FaiyuetCik/Display-Gadgets/code/images/096_nRF52840Plus_display_dashboard_motion.gif

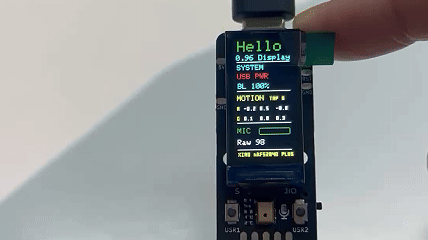
code/images/096_nRF52840Plus_display_dashboard_motion.gif
