FaiyuetCik/Display-Gadgets/code/example/096_nRF52840/crop1.jpg

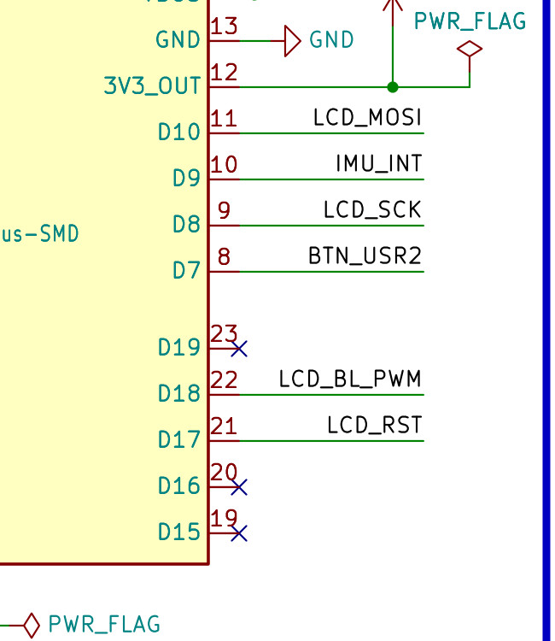
code/example/096_nRF52840/crop1.jpg
