FaiyuetCik/Display-Gadgets/code/example/096_nRF52840/crop2.jpg

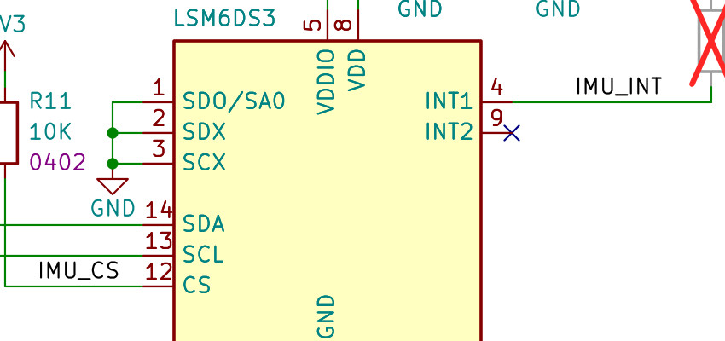
code/example/096_nRF52840/crop2.jpg
