FaiyuetCik/Display-Gadgets/code/example/096_nRF52840/schematic_main.png

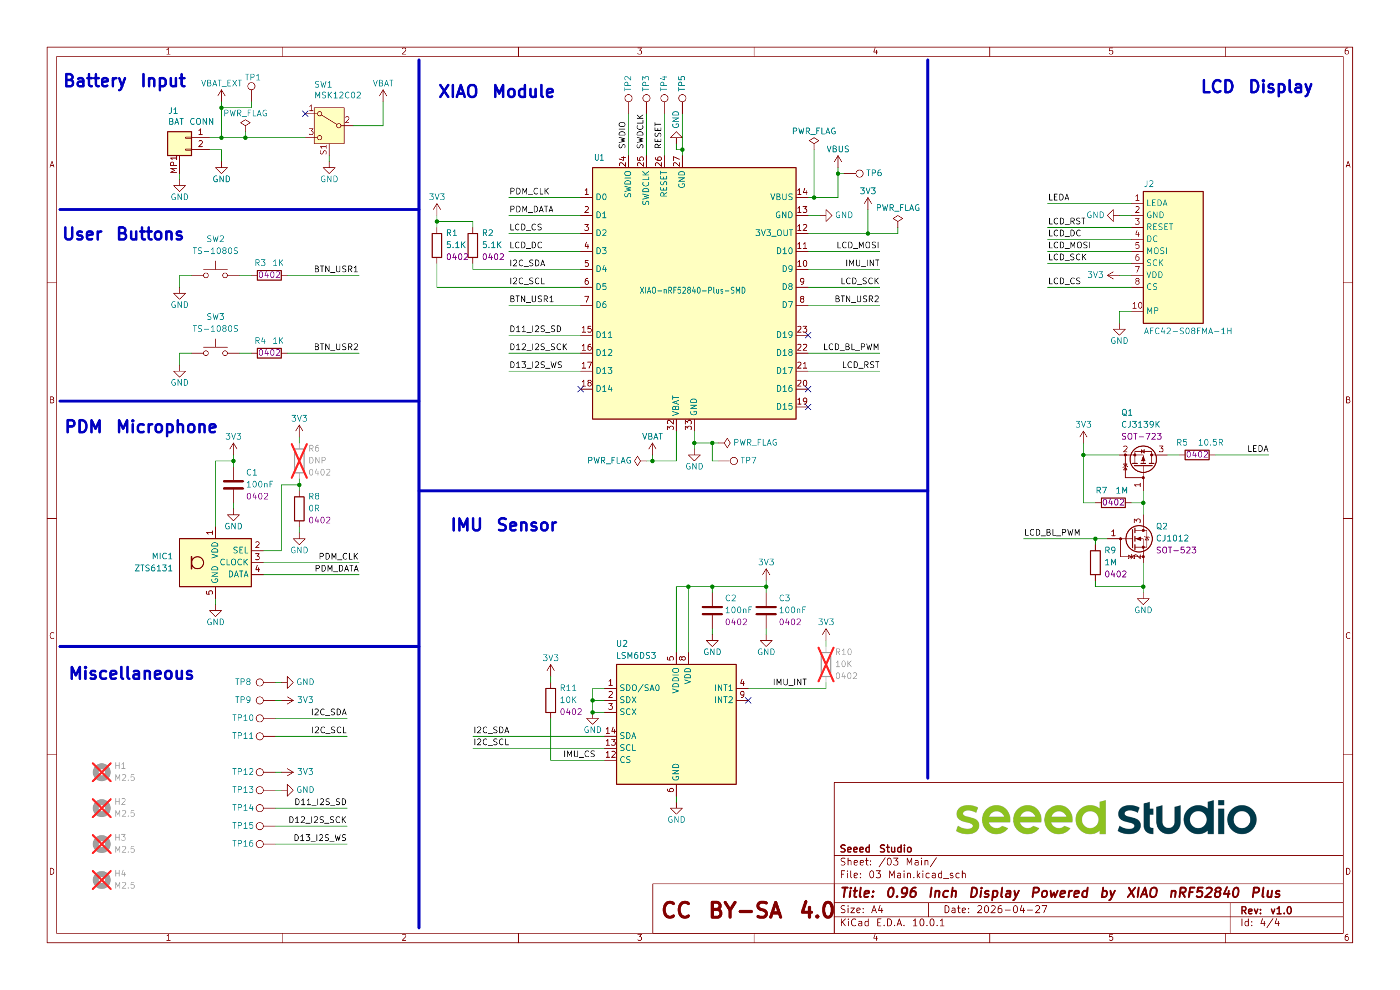
code/example/096_nRF52840/schematic_main.png
