FaiyuetCik/Display-Gadgets/code/images/096_ESP32S3Plus_display_dashboard_double_tap.gif

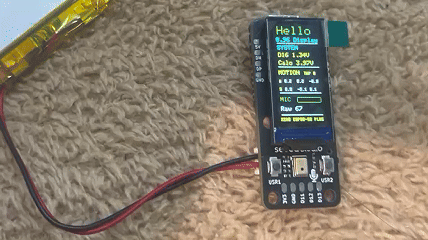
code/images/096_ESP32S3Plus_display_dashboard_double_tap.gif
