FaiyuetCik/Display-Gadgets/code/images/096_ESP32S3Plus_display_dashboard_mic.gif

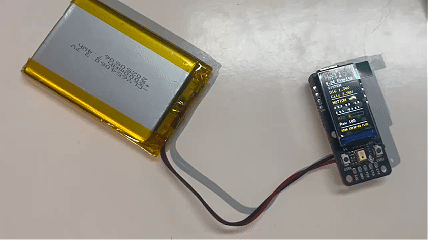
code/images/096_ESP32S3Plus_display_dashboard_mic.gif
