FaiyuetCik/Display-Gadgets/code/images/096_ESP32S3Plus_display_dashboard_uploadpage.png

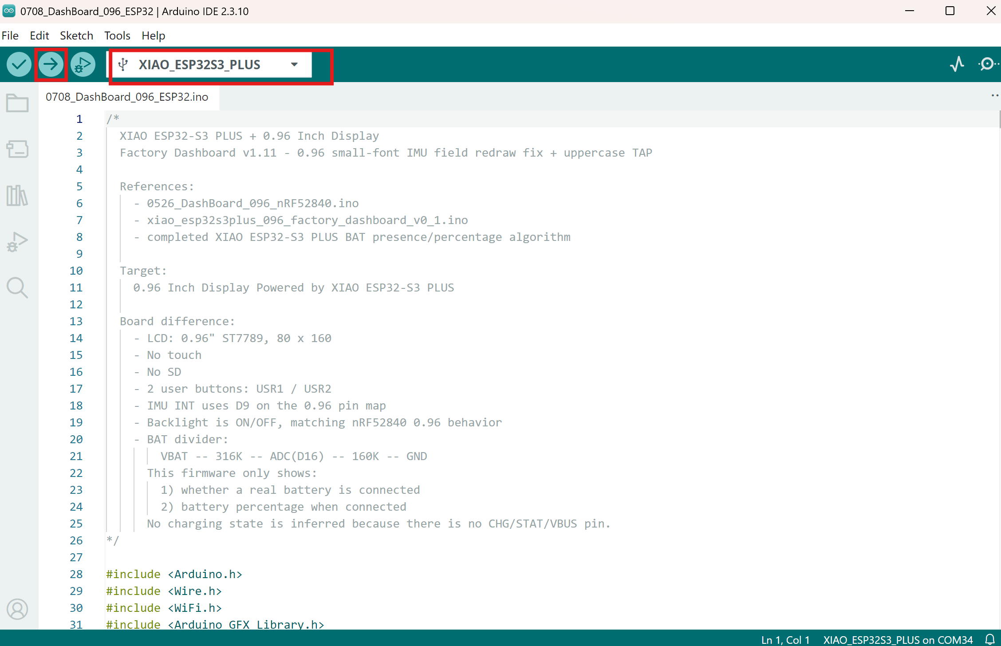
code/images/096_ESP32S3Plus_display_dashboard_uploadpage.png
