FaiyuetCik/Display-Gadgets/code/images/096_ESP32S3Plus_function_graphictest.gif

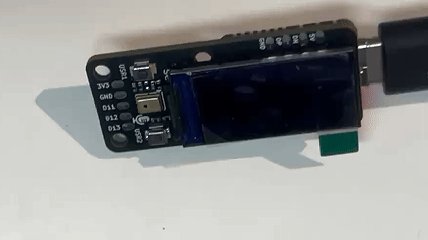
code/images/096_ESP32S3Plus_function_graphictest.gif
