FaiyuetCik/Display-Gadgets/code/images/096_ESP32S3Plus_function_quicksand.gif

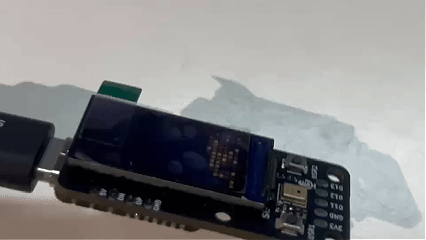
code/images/096_ESP32S3Plus_function_quicksand.gif
