FaiyuetCik/Display-Gadgets/code/images/096_nRF52840Plus_display_dashboard_uploadpage.png

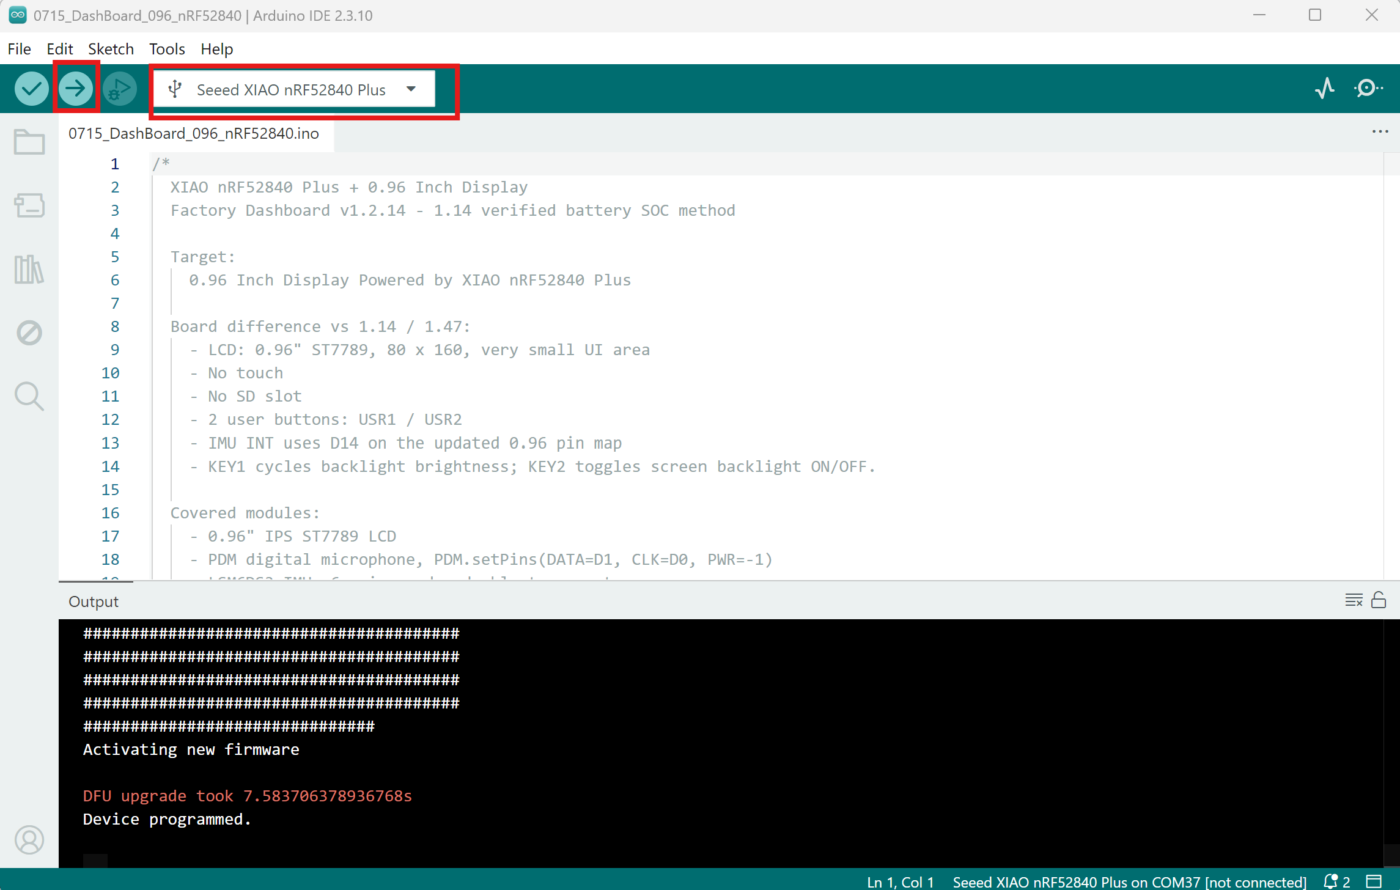
code/images/096_nRF52840Plus_display_dashboard_uploadpage.png
