FaiyuetCik/Display-Gadgets/code/images/096_nRF52840Plus_function_flash_record.gif

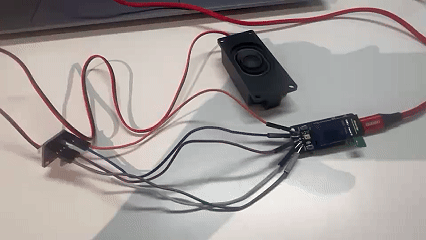
code/images/096_nRF52840Plus_function_flash_record.gif
