FaiyuetCik/Display-Gadgets/code/images/096_nRF52840Plus_function_quicksand.gif

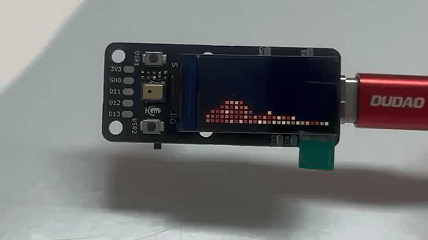
code/images/096_nRF52840Plus_function_quicksand.gif
