FaiyuetCik/Display-Gadgets/code/images/096_nRF52840Plus_function_wakeup.gif

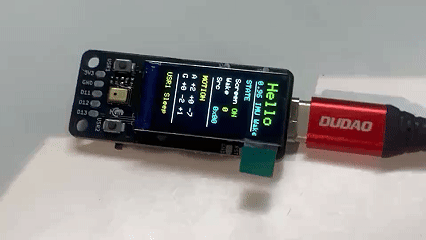
code/images/096_nRF52840Plus_function_wakeup.gif
