FaiyuetCik/Display-Gadgets/code/images/114_ESP32S3Plus_display_battery_states2.jpg

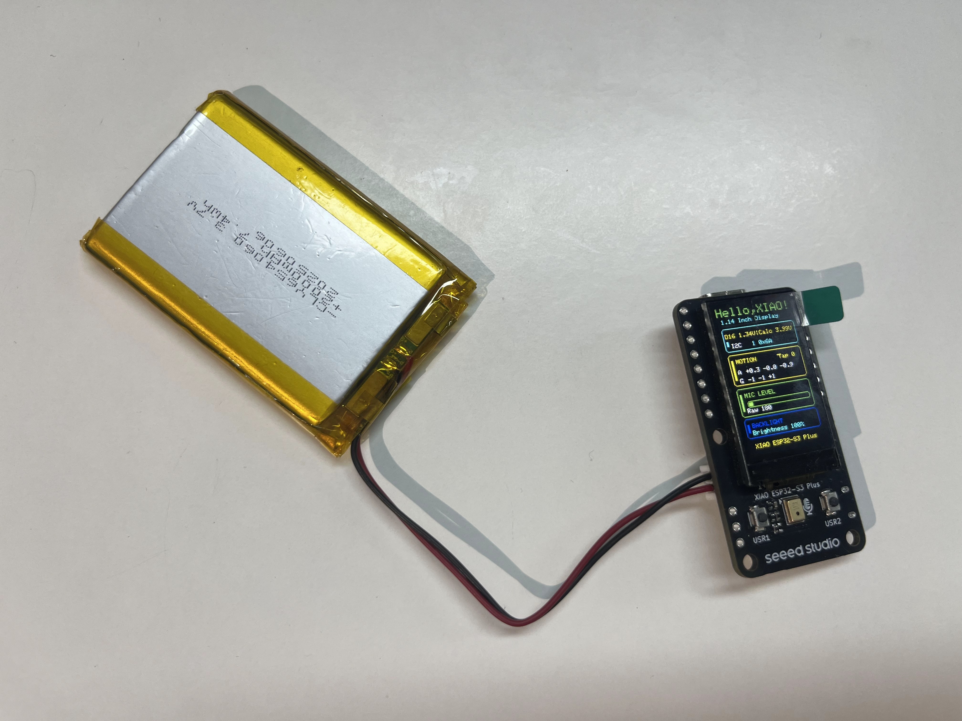
code/images/114_ESP32S3Plus_display_battery_states2.jpg
