FaiyuetCik/Display-Gadgets/code/images/114_ESP32S3Plus_display_dashboard_button.gif

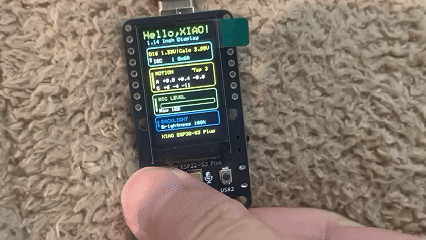
code/images/114_ESP32S3Plus_display_dashboard_button.gif
