FaiyuetCik/Display-Gadgets/code/images/114_ESP32S3Plus_display_dashboard_i2c_scan.jpg

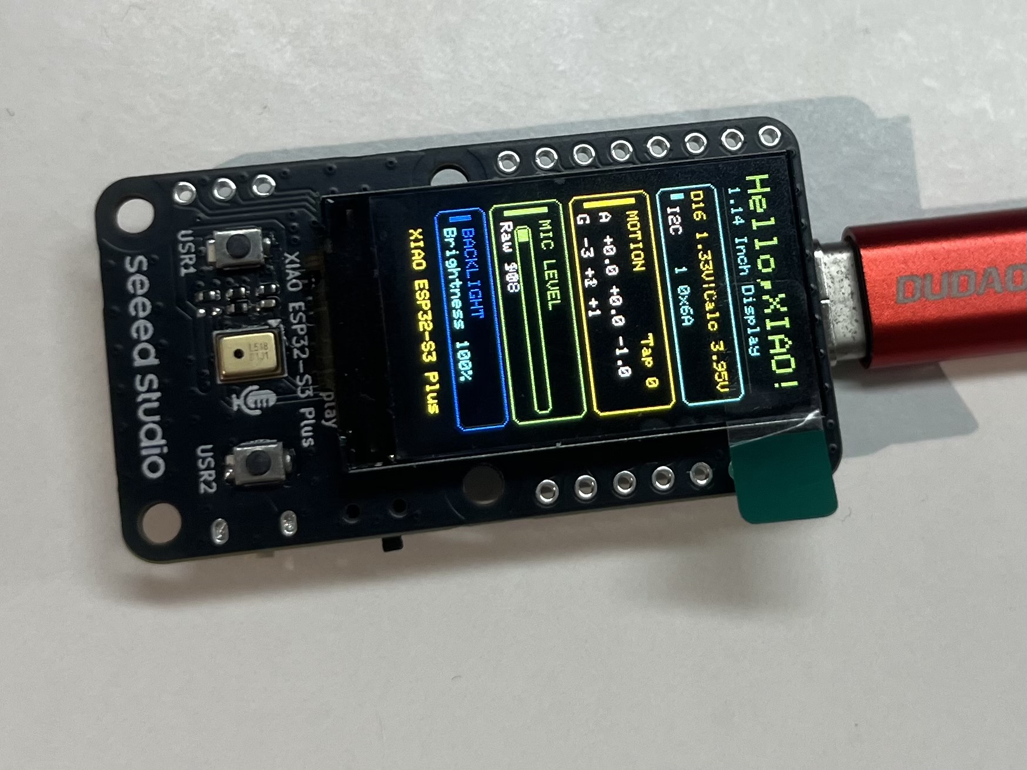
code/images/114_ESP32S3Plus_display_dashboard_i2c_scan.jpg
