FaiyuetCik/Display-Gadgets/code/images/114_ESP32S3Plus_display_dashboard_uploadpage.png

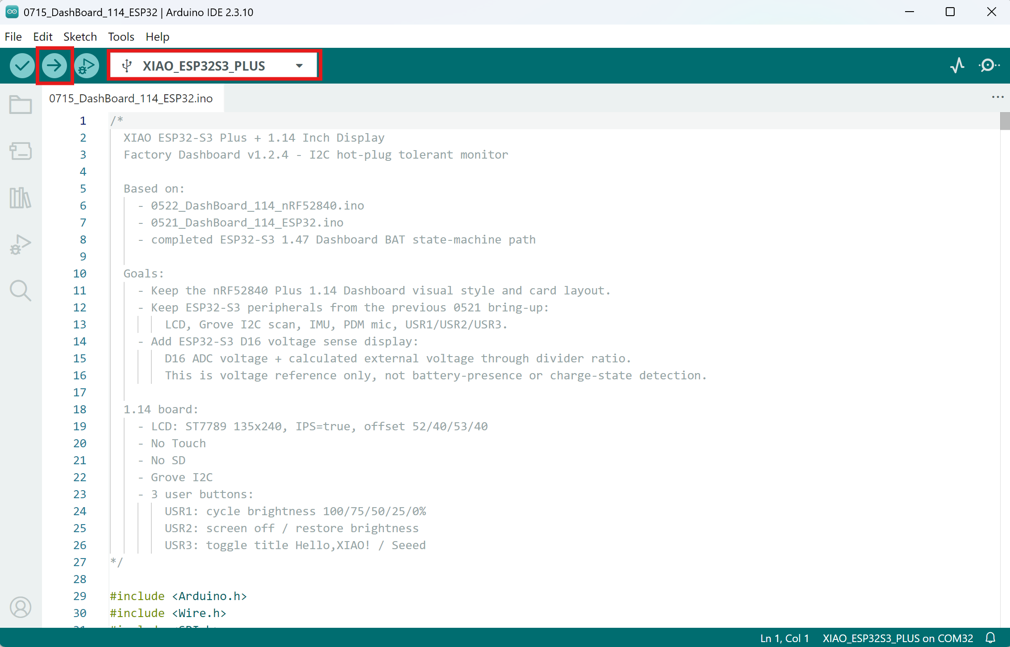
code/images/114_ESP32S3Plus_display_dashboard_uploadpage.png
