FaiyuetCik/Display-Gadgets/code/images/114_ESP32S3Plus_function_flash_record.gif

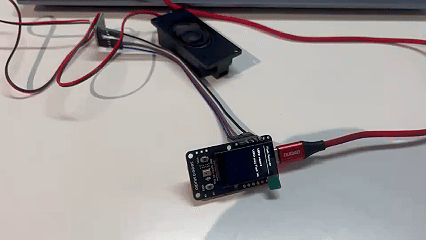
code/images/114_ESP32S3Plus_function_flash_record.gif
