FaiyuetCik/Display-Gadgets/code/images/114_ESP32S3Plus_function_quicksand.gif

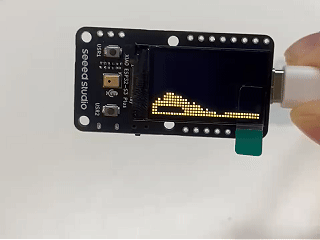
code/images/114_ESP32S3Plus_function_quicksand.gif
