FaiyuetCik/Display-Gadgets/code/images/114_ESP32S3Plus_function_voice_bar.gif

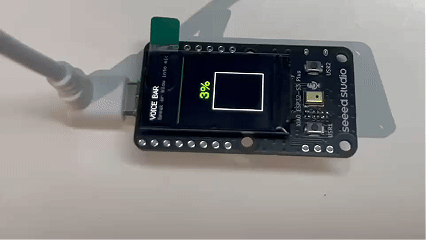
code/images/114_ESP32S3Plus_function_voice_bar.gif
