FaiyuetCik/Display-Gadgets/code/images/114_ESP32S3Plus_function_wakeup.gif

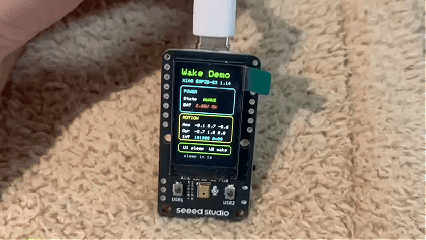
code/images/114_ESP32S3Plus_function_wakeup.gif
