FaiyuetCik/Display-Gadgets/code/images/114_nRF52840Plus_display_battery_states1.jpg

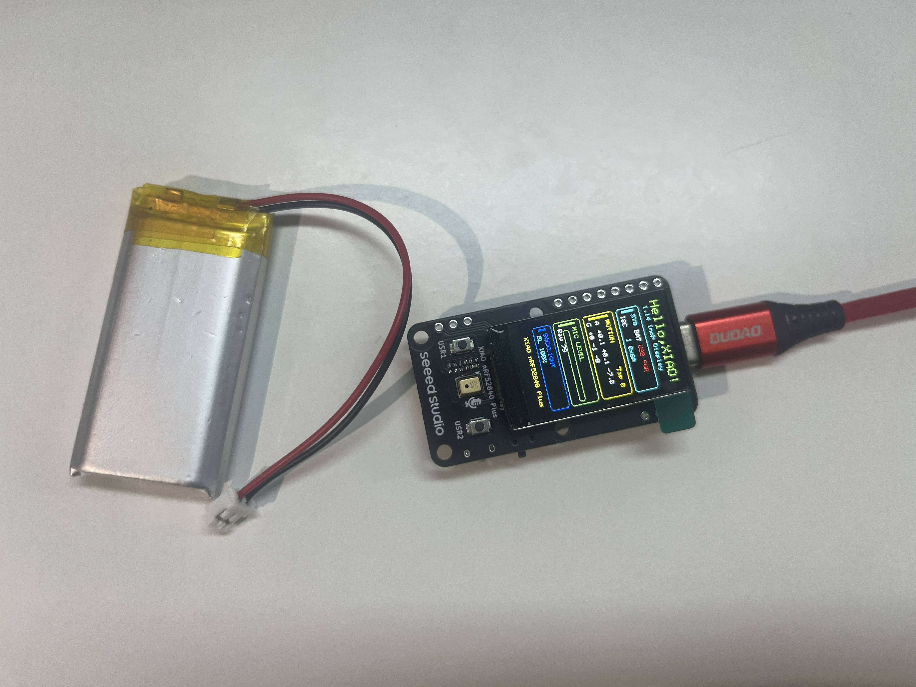
code/images/114_nRF52840Plus_display_battery_states1.jpg
