FaiyuetCik/Display-Gadgets/code/images/114_nRF52840Plus_display_battery_states3.jpg

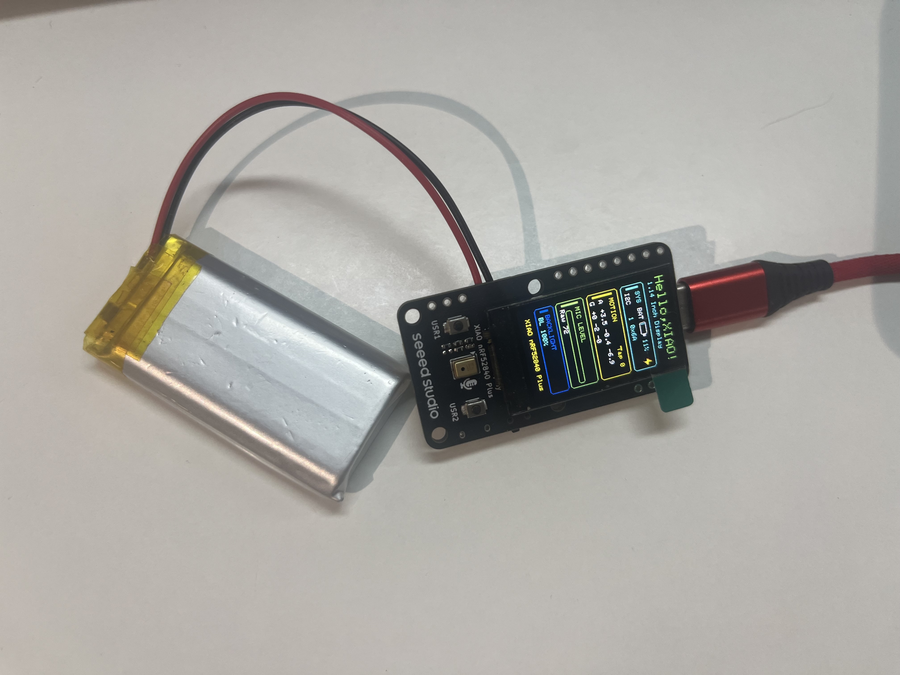
code/images/114_nRF52840Plus_display_battery_states3.jpg
