FaiyuetCik/Display-Gadgets/code/images/114_nRF52840Plus_display_battery_states4.jpg

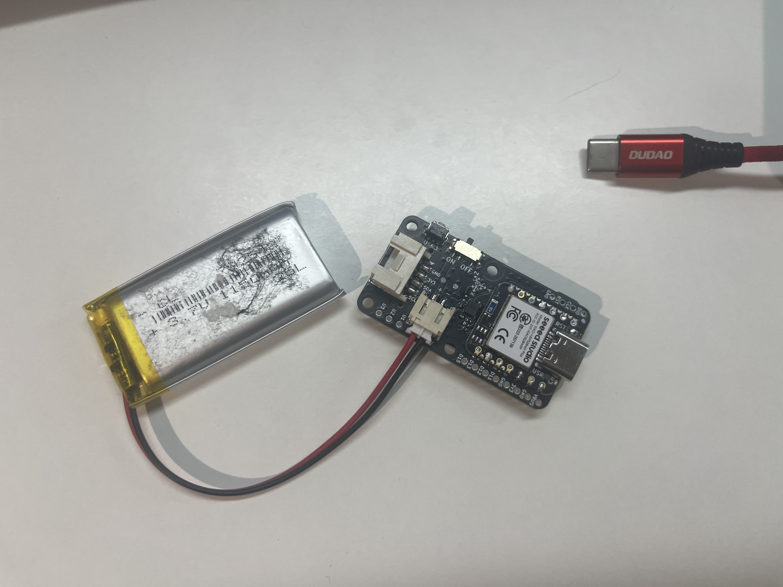
code/images/114_nRF52840Plus_display_battery_states4.jpg
