FaiyuetCik/Display-Gadgets/code/images/114_nRF52840Plus_display_dashboard_double_tap.gif

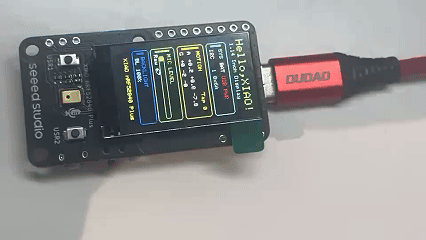
code/images/114_nRF52840Plus_display_dashboard_double_tap.gif
