FaiyuetCik/Display-Gadgets/code/images/114_nRF52840Plus_display_dashboard_i2c_scan.jpg

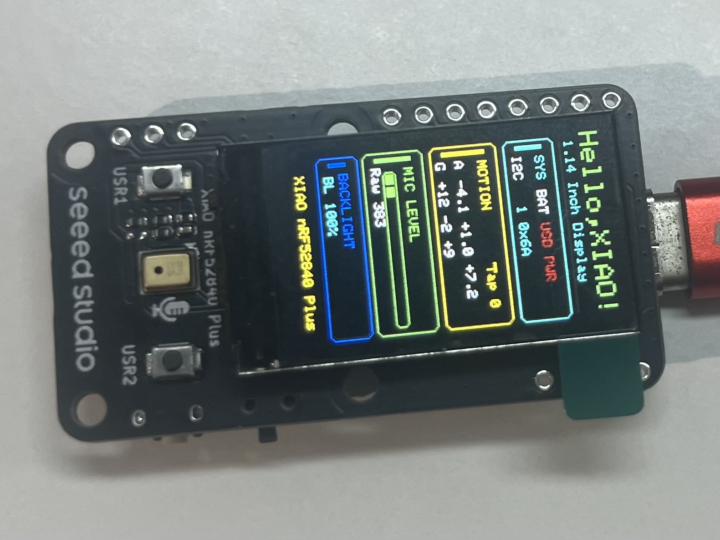
code/images/114_nRF52840Plus_display_dashboard_i2c_scan.jpg
