FaiyuetCik/Display-Gadgets/code/images/114_nRF52840Plus_display_dashboard_mic.gif

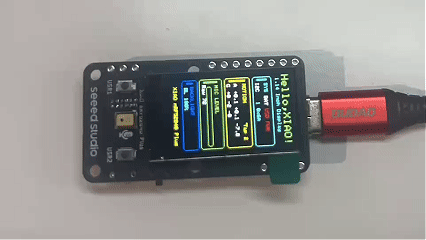
code/images/114_nRF52840Plus_display_dashboard_mic.gif
