FaiyuetCik/Display-Gadgets/code/images/114_nRF52840Plus_function_flash_record_i2s.gif

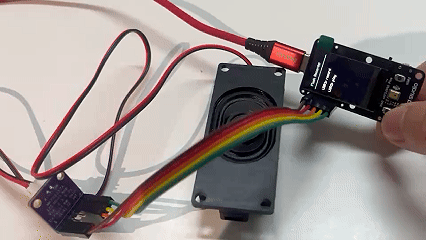
code/images/114_nRF52840Plus_function_flash_record_i2s.gif
