FaiyuetCik/Display-Gadgets/code/images/114_nRF52840Plus_function_graphictest.gif

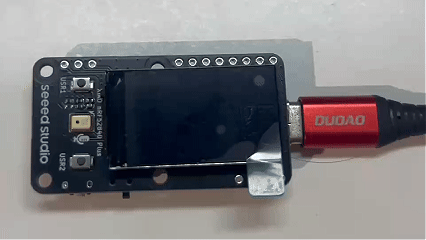
code/images/114_nRF52840Plus_function_graphictest.gif
