FaiyuetCik/Display-Gadgets/code/images/114_nRF52840Plus_function_quicksand.gif

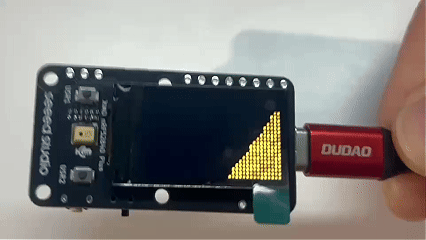
code/images/114_nRF52840Plus_function_quicksand.gif
