FaiyuetCik/Display-Gadgets/code/images/114_nRF52840Plus_function_voice_bar.gif

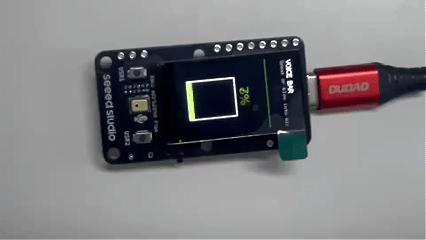
code/images/114_nRF52840Plus_function_voice_bar.gif
