FaiyuetCik/Display-Gadgets/code/images/114_nRF52840Plus_function_wakeup.gif

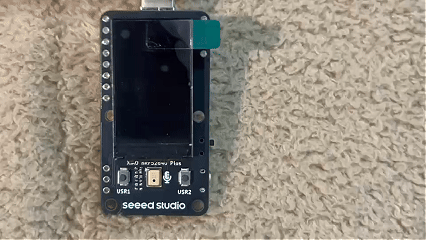
code/images/114_nRF52840Plus_function_wakeup.gif
