FaiyuetCik/Display-Gadgets/code/images/147_ESP32S3Plus_function_graphictest.gif

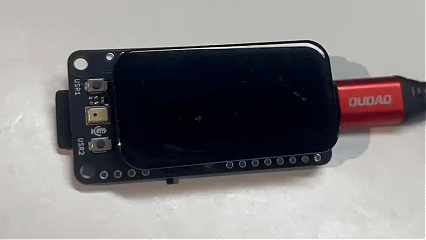
code/images/147_ESP32S3Plus_function_graphictest.gif
