FaiyuetCik/Display-Gadgets/code/images/147_ESP32S3Plus_function_sd_bmp_reader.gif

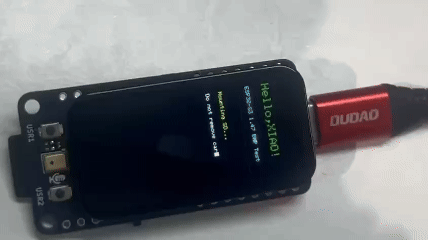
code/images/147_ESP32S3Plus_function_sd_bmp_reader.gif
