FaiyuetCik/Display-Gadgets/code/images/147_ESP32S3Plus_function_sd_record_i2s.gif

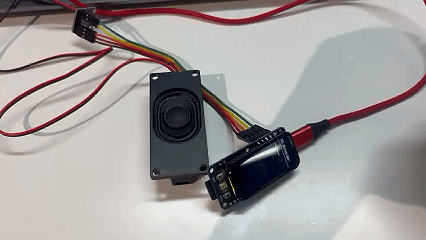
code/images/147_ESP32S3Plus_function_sd_record_i2s.gif
