FaiyuetCik/Display-Gadgets/code/images/147_ESP32S3Plus_function_touch_circle.gif

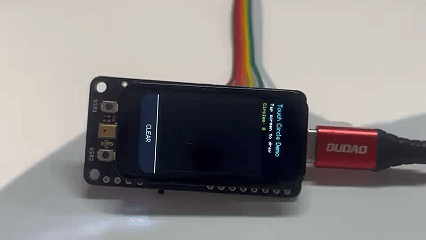
code/images/147_ESP32S3Plus_function_touch_circle.gif
