FaiyuetCik/Display-Gadgets/code/images/147_ESP32S3Plus_touch_display_battery_states3.jpg

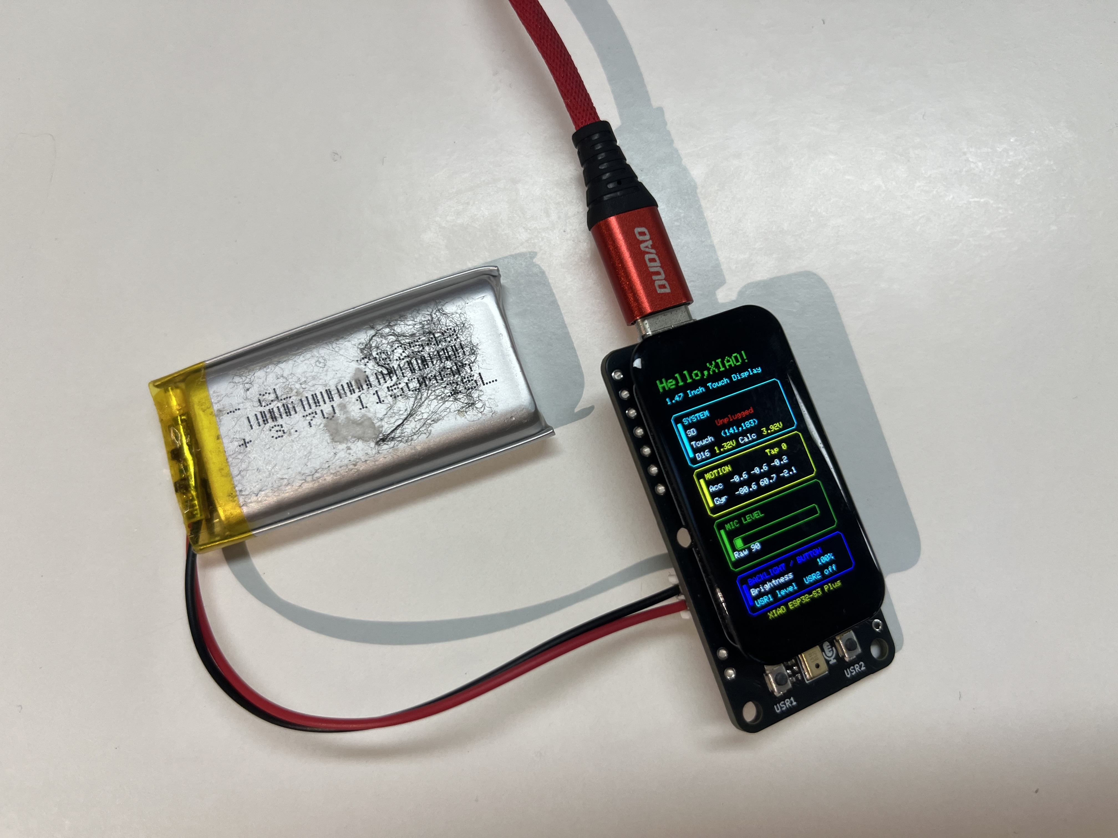
code/images/147_ESP32S3Plus_touch_display_battery_states3.jpg
