FaiyuetCik/Display-Gadgets/code/images/147_ESP32S3Plus_touch_display_dashboard_sd_card.gif

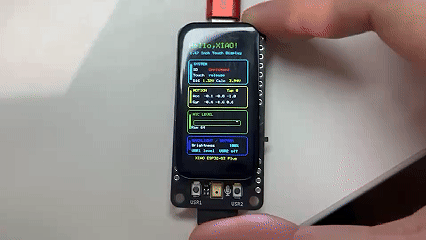
code/images/147_ESP32S3Plus_touch_display_dashboard_sd_card.gif
