FaiyuetCik/Display-Gadgets/code/images/147_esp32s3Plus_touch_display_dashboard_uploadpage.png

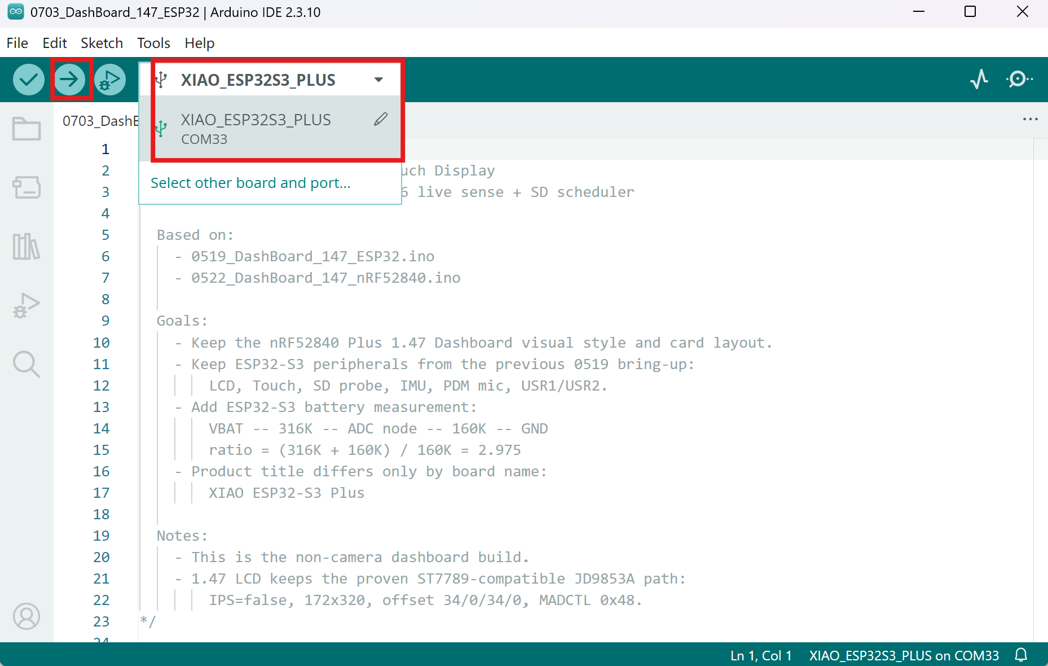
code/images/147_esp32s3Plus_touch_display_dashboard_uploadpage.png
