FaiyuetCik/Display-Gadgets/code/images/147_esp32s3Plus_touch_display_way_to_find_the_correct_board.png

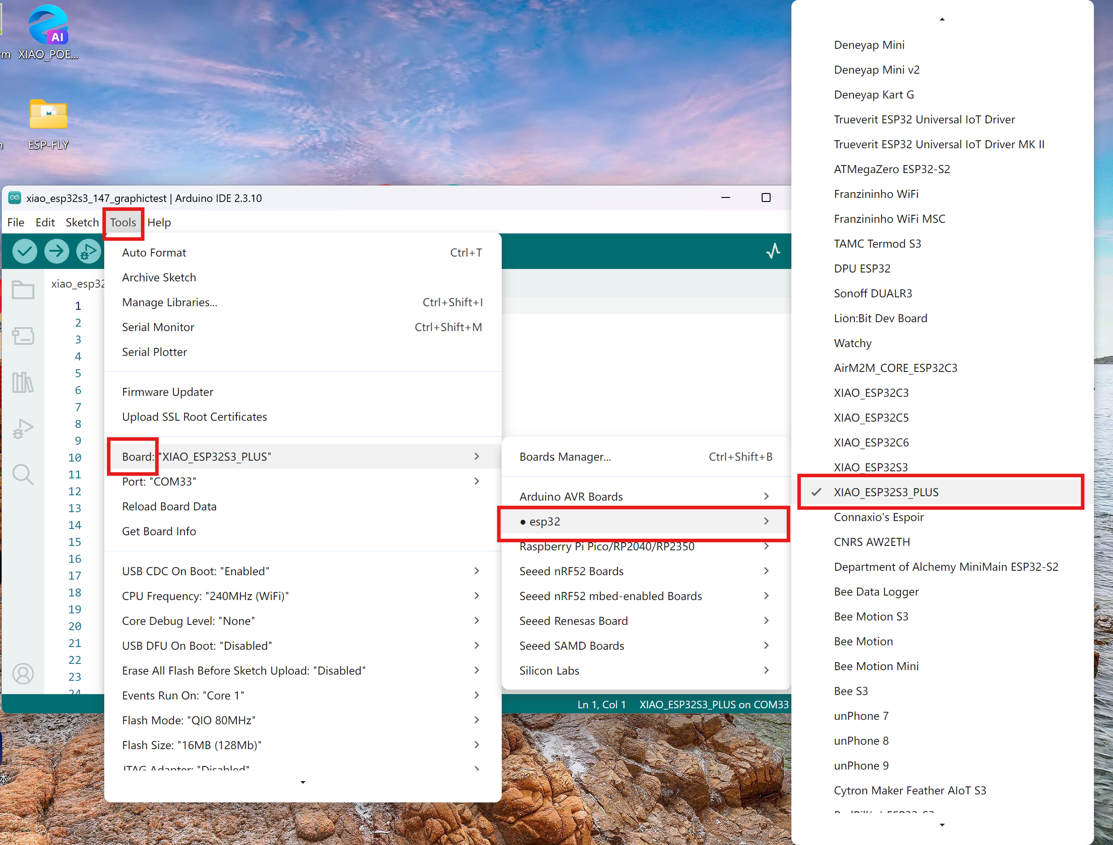
code/images/147_esp32s3Plus_touch_display_way_to_find_the_correct_board.png
