FaiyuetCik/Display-Gadgets/code/images/147_nRF52840Plus_function_mic_bar.gif

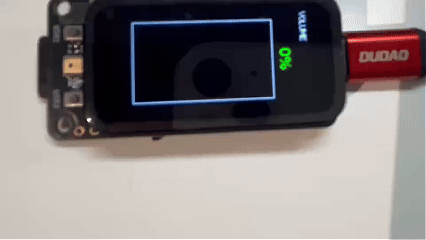
code/images/147_nRF52840Plus_function_mic_bar.gif
