FaiyuetCik/Display-Gadgets/code/images/147_nRF52840Plus_function_quicksand.gif

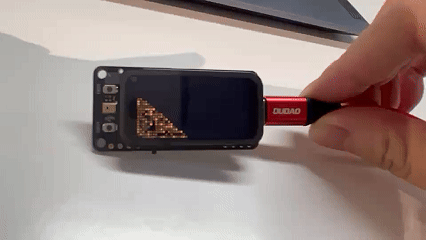
code/images/147_nRF52840Plus_function_quicksand.gif
