FaiyuetCik/Display-Gadgets/code/images/147_nRF52840Plus_function_sd_reader.gif

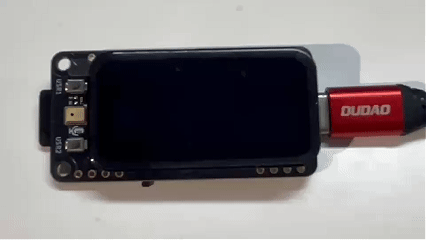
code/images/147_nRF52840Plus_function_sd_reader.gif
