FaiyuetCik/Display-Gadgets/code/images/147_nRF52840Plus_function_touch_circle.gif

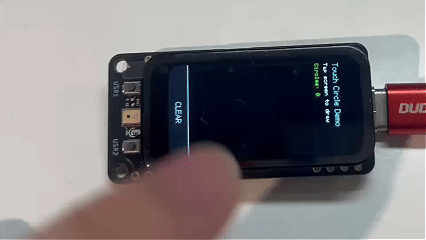
code/images/147_nRF52840Plus_function_touch_circle.gif
