FaiyuetCik/Display-Gadgets/code/images/147_nRF52840Plus_function_wakeup.gif

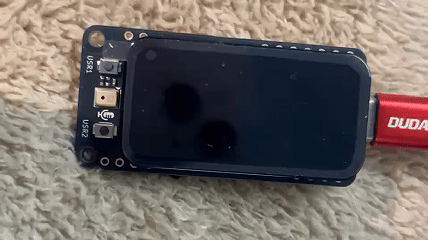
code/images/147_nRF52840Plus_function_wakeup.gif
