FaiyuetCik/Display-Gadgets/code/images/147_nRF52840Plus_touch_display_battery_states1.jpg

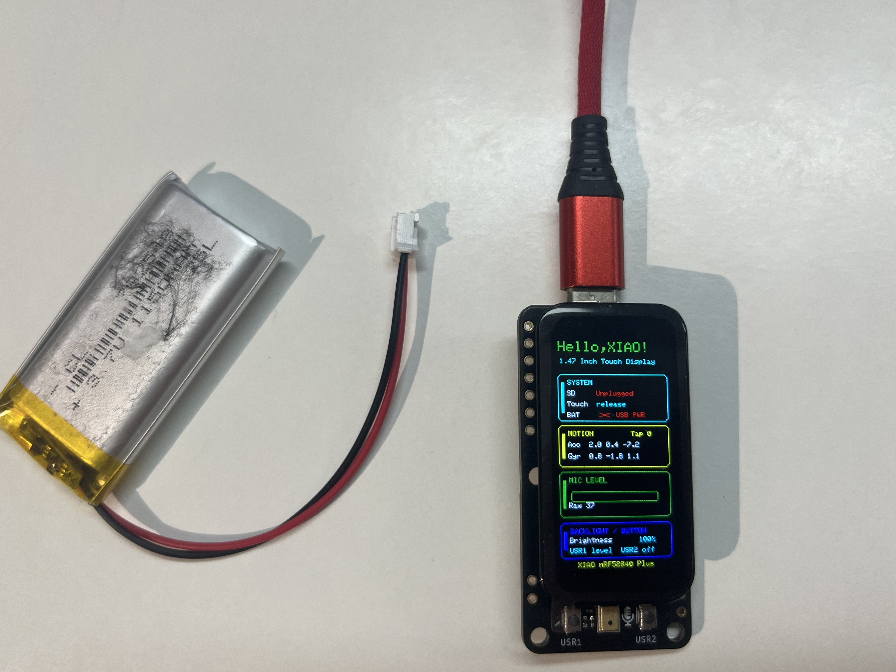
code/images/147_nRF52840Plus_touch_display_battery_states1.jpg
