FaiyuetCik/Display-Gadgets/code/images/147_nRF52840Plus_touch_display_dashboard_button.gif

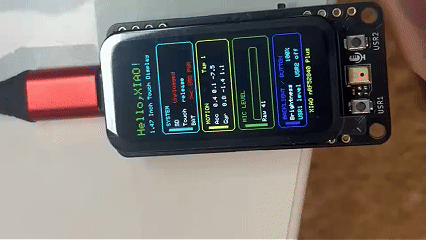
code/images/147_nRF52840Plus_touch_display_dashboard_button.gif
