FaiyuetCik/Display-Gadgets/code/images/147_nRF52840Plus_touch_display_dashboard_mic.gif

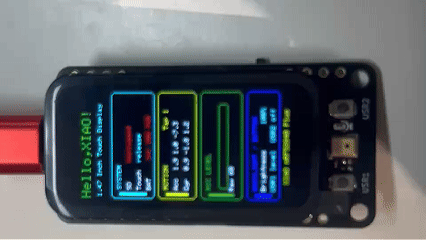
code/images/147_nRF52840Plus_touch_display_dashboard_mic.gif
