FaiyuetCik/Display-Gadgets/code/images/147_nRF52840Plus_touch_display_dashboard_motion.gif

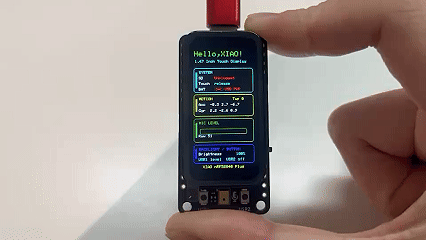
code/images/147_nRF52840Plus_touch_display_dashboard_motion.gif
