FaiyuetCik/Display-Gadgets/code/images/147_nRF52840Plus_touch_display_dashboard_sd_card.gif

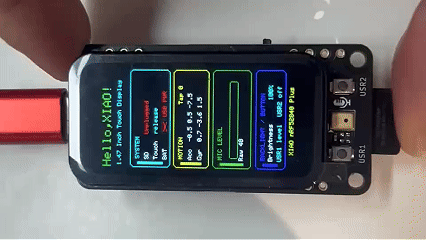
code/images/147_nRF52840Plus_touch_display_dashboard_sd_card.gif
