FaiyuetCik/Display-Gadgets/code/images/xiao_esp32s3_147_bat.jpg

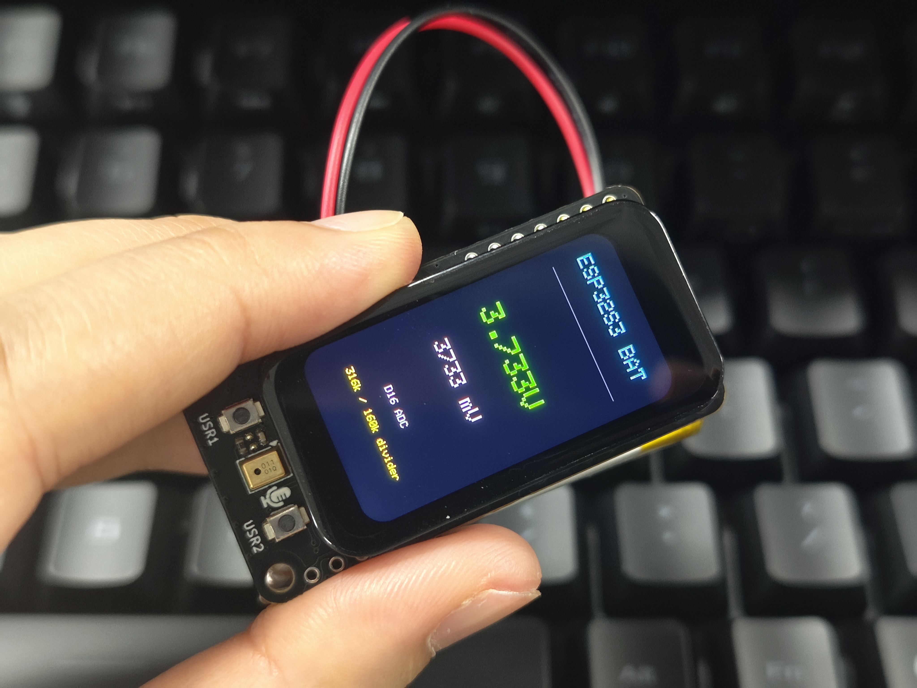
code/images/xiao_esp32s3_147_bat.jpg
