FaiyuetCik/Display-Gadgets/code/images/xiao_nrf52840_147_bat.jpg

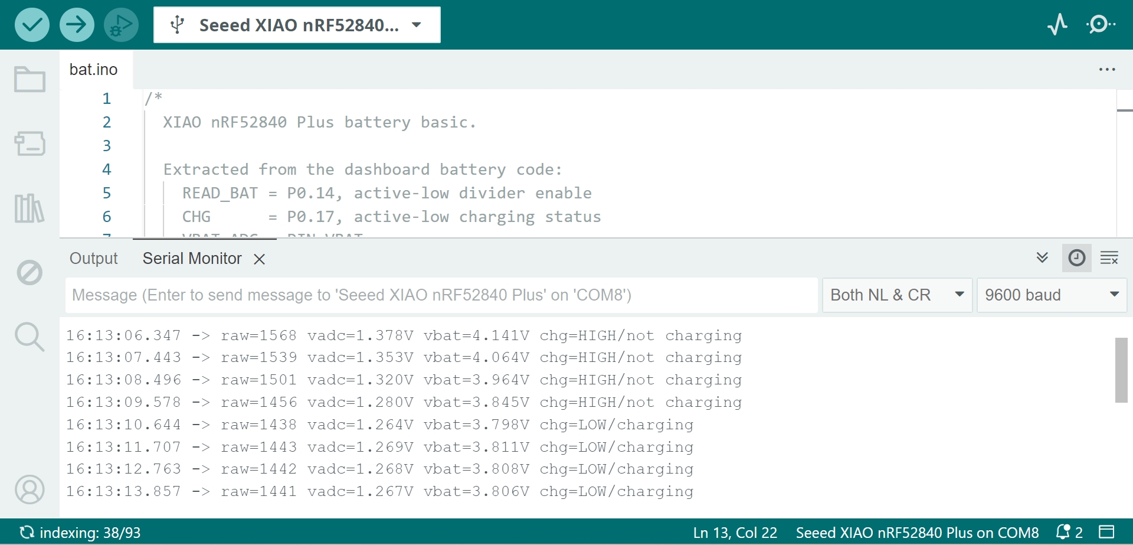
code/images/xiao_nrf52840_147_bat.jpg
