FaiyuetCik/Display-Gadgets/code/images/xiao_nrf52840_147_button.jpg

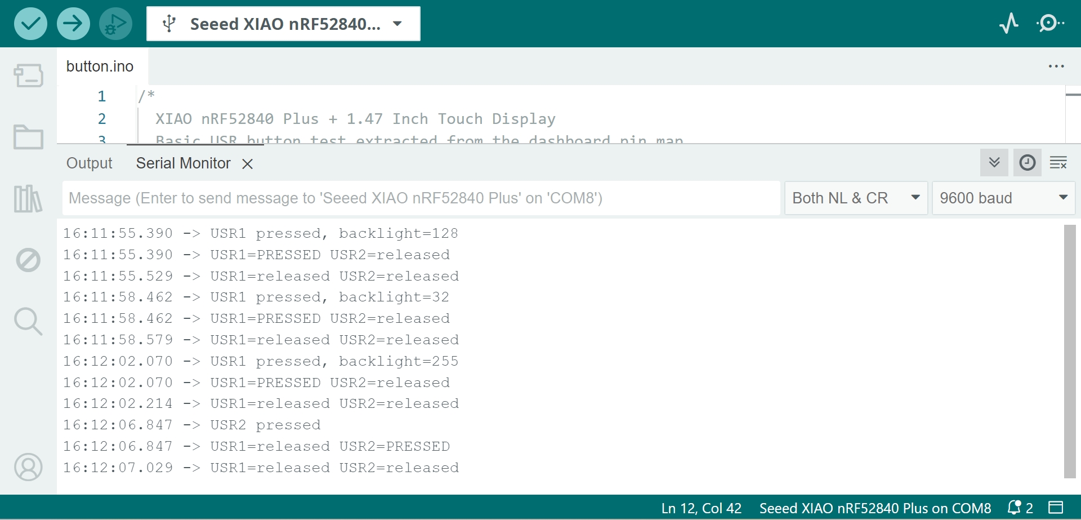
code/images/xiao_nrf52840_147_button.jpg
