FaiyuetCik/Display-Gadgets/code/images/xiao_nrf52840_147_display.jpg

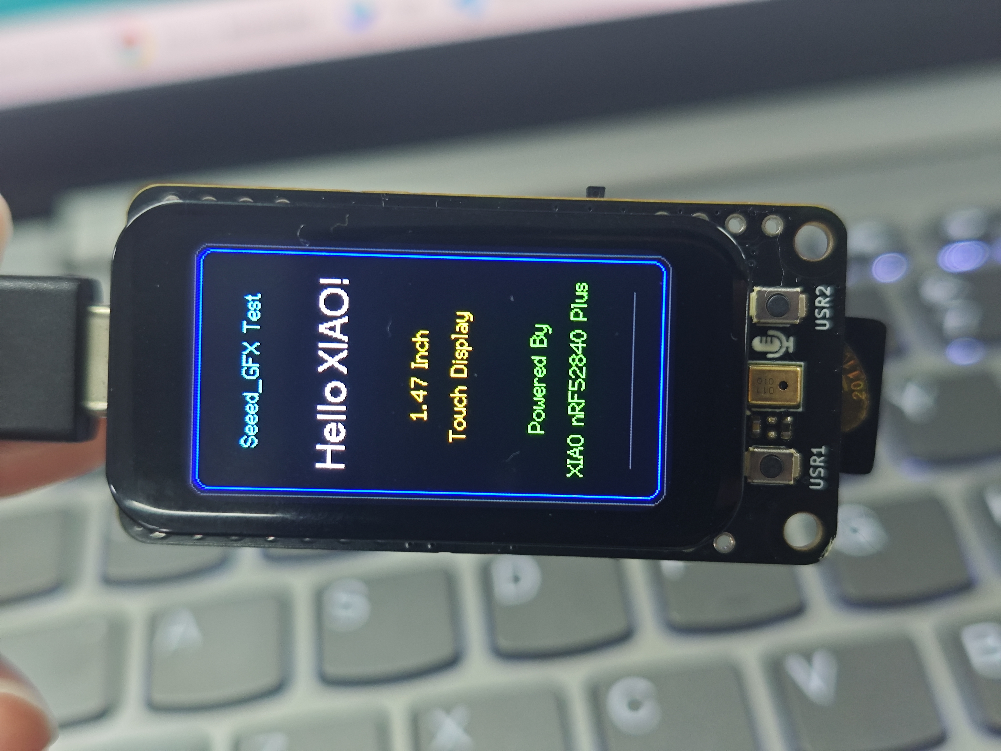
code/images/xiao_nrf52840_147_display.jpg
