FaiyuetCik/Display-Gadgets/code/images/xiao_nrf52840_147_imu.jpg

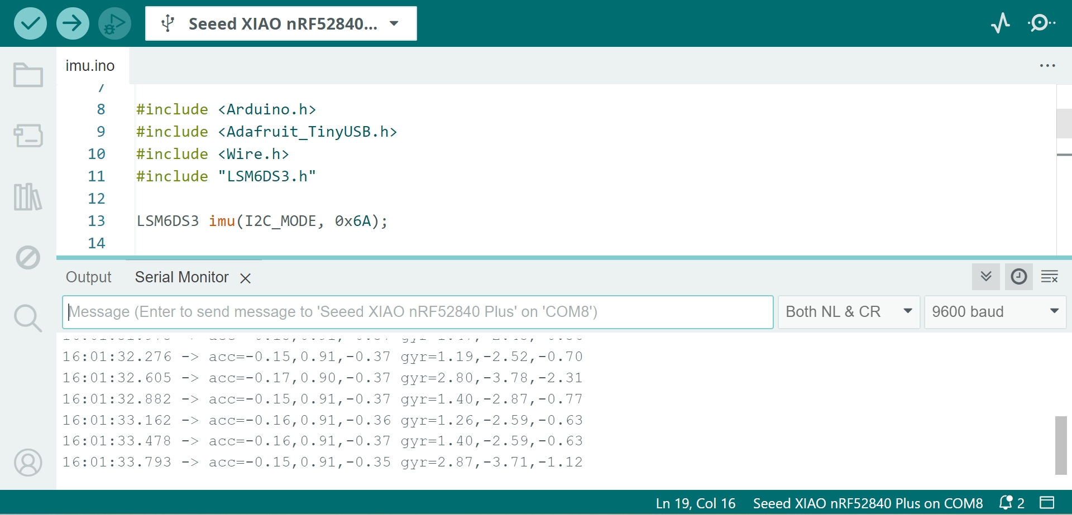
code/images/xiao_nrf52840_147_imu.jpg
