FaiyuetCik/Display-Gadgets/code/images/xiao_nrf52840_147_mic.jpg

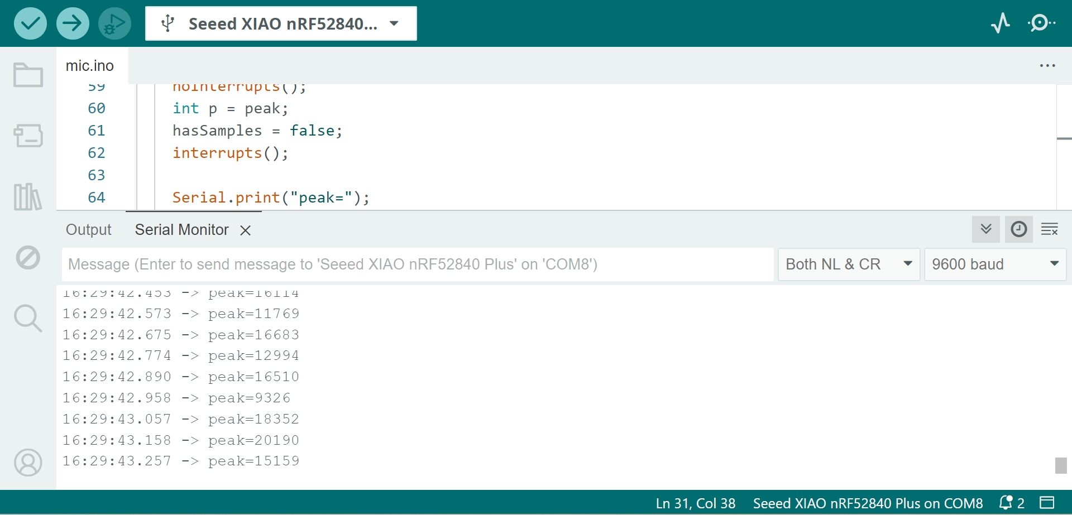
code/images/xiao_nrf52840_147_mic.jpg
