FaiyuetCik/Display-Gadgets/code/images/xiao_nrf52840_147_sd.jpg

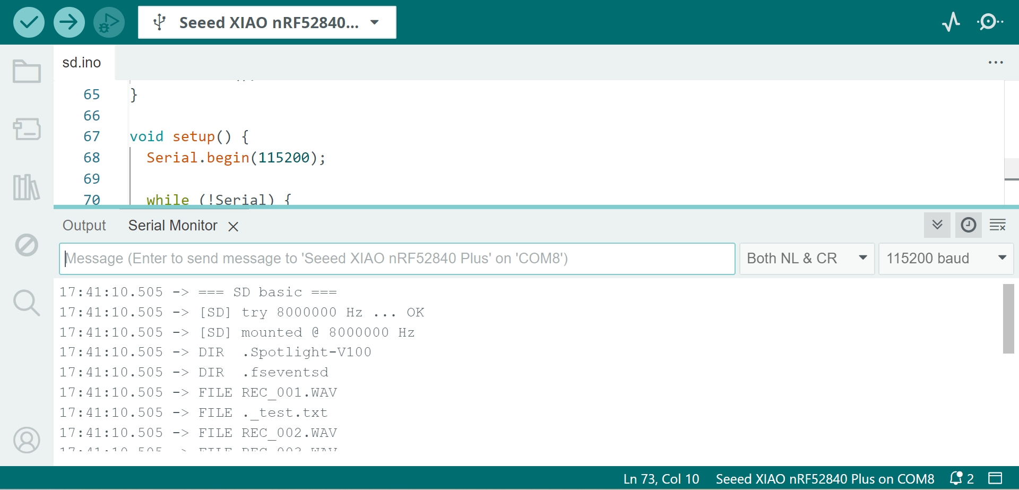
code/images/xiao_nrf52840_147_sd.jpg
