FaiyuetCik/Display-Gadgets/code/images/xiao_nrf52840_147_touch_int.jpg

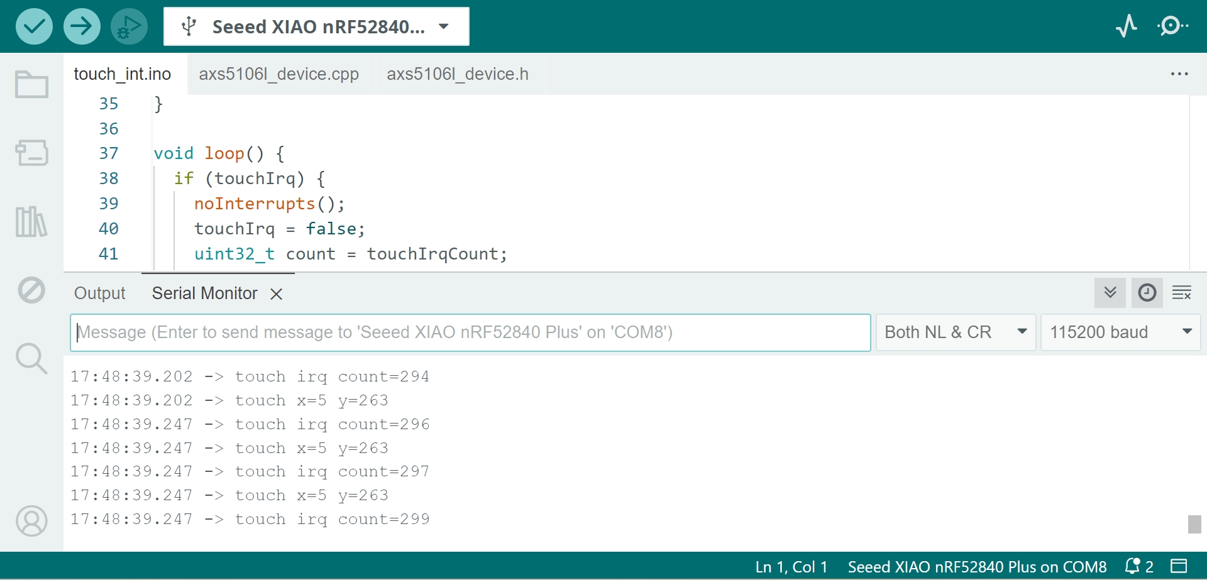
code/images/xiao_nrf52840_147_touch_int.jpg
