FaiyuetCik/Display-Gadgets/code/images/xiao_nrf52840_147_wakeup_1.jpg

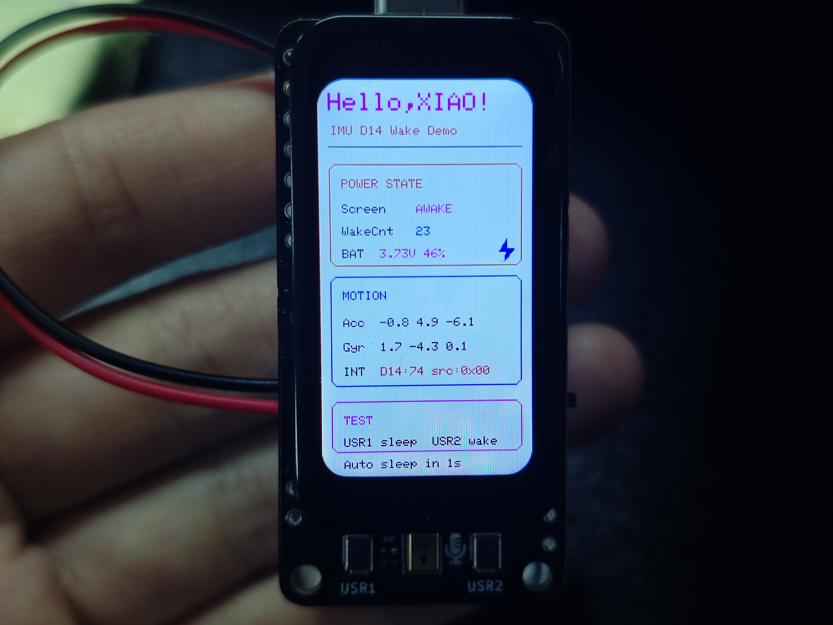
code/images/xiao_nrf52840_147_wakeup_1.jpg
