FaiyuetCik/Display-Gadgets/code/images/xiao_nrf52840_147_wakeup_3.gif

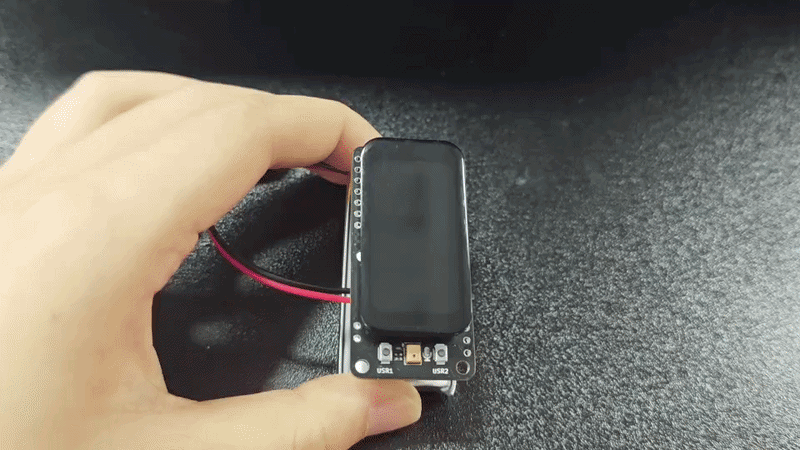
code/images/xiao_nrf52840_147_wakeup_3.gif
