FaiyuetCik/Display-Gadgets/code/example/114_nRF52840/1.14 Inch Display Powered by XIAO nRF52840 Plus_v1.0.pdf

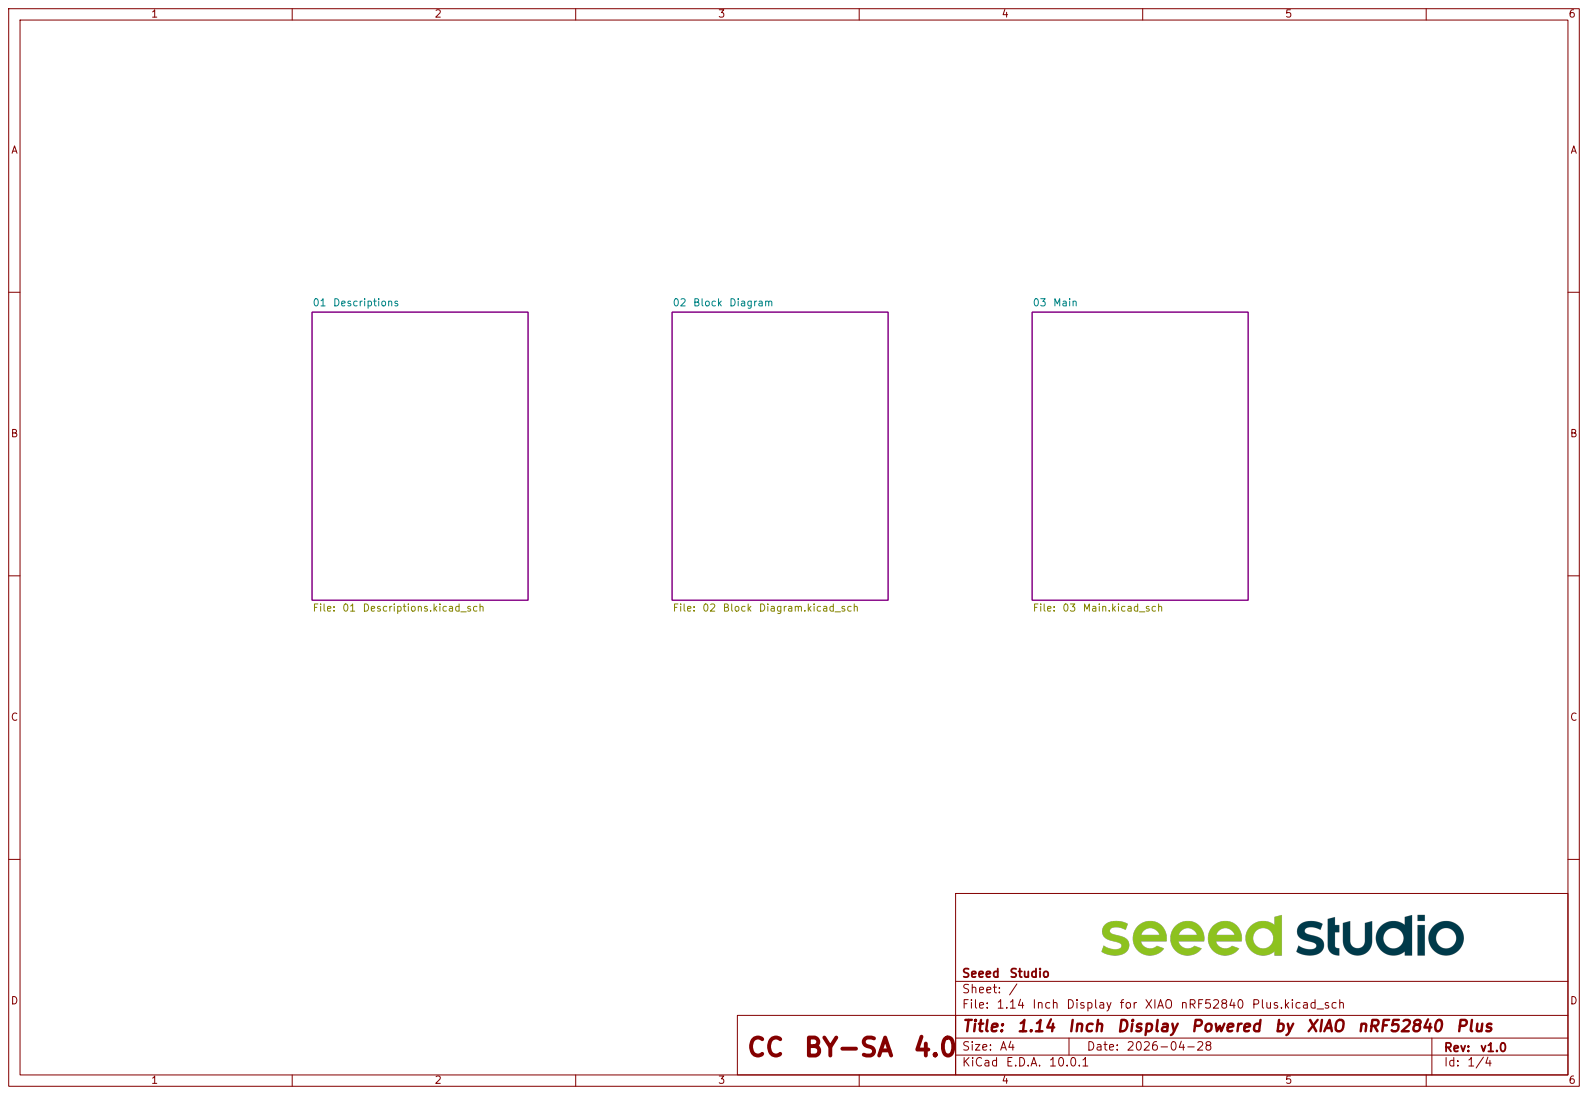
[picture p124: page 1]

Seeed Studio
Sheet: /
File: 1.14 Inch Display for XIAO nRF52840 Plus.kicad_sch

CC BY-SA 4.0 | Title: 1.14 Inch Display Powered by XIAO nRF52840 Plus

Size: A4 | | Rev: v1.0
KiCad E.D.A. 10.0.1 | | Id: 1/4

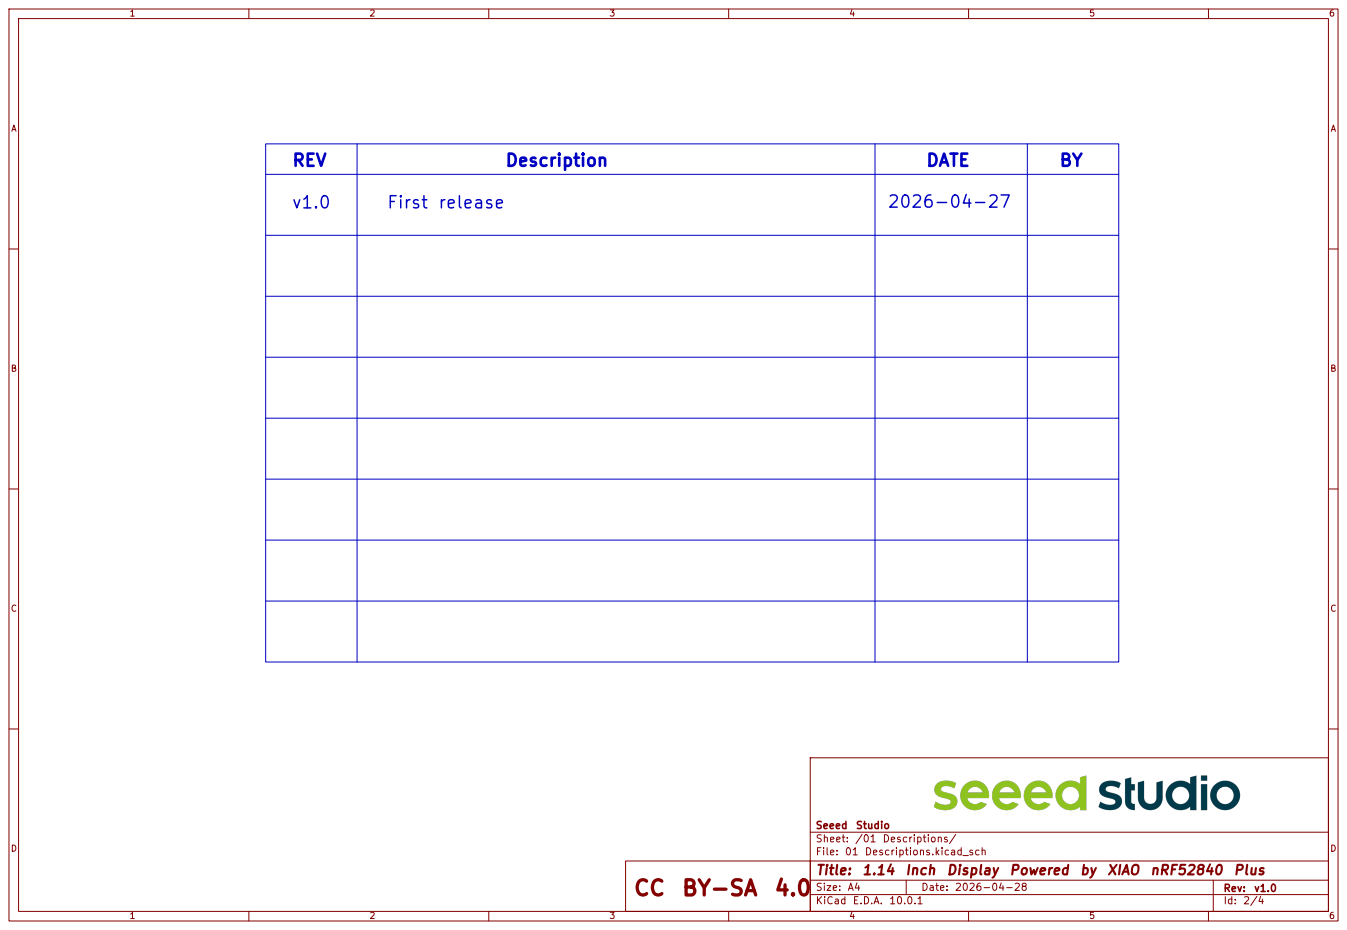
[picture p125: page 2]

REV | Description | DATE | BY

v1.0 | First release | 2026-04-27

Seeed Studio
Sheet: /01 Descriptions/
File: 01 Descriptions.kicad_sch
Title: 1.14 Inch Display Powered by XIAO nRF52840 Plus

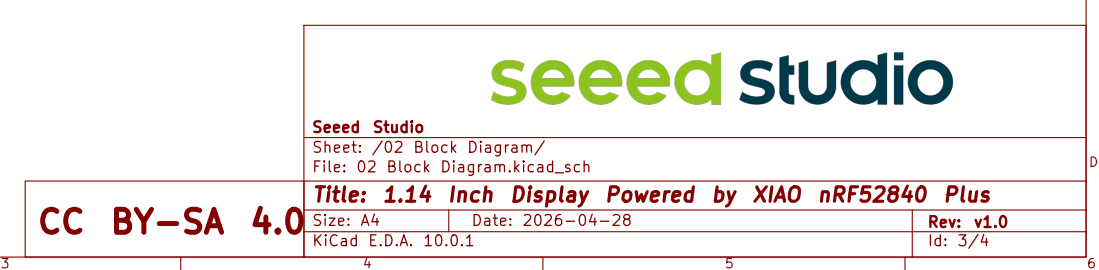
[picture p126: page 3]

Seeed Studio
Sheet: /02 Block Diagram/
File: 02 Block Diagram.kicad_sch
Title: 1.14 Inch Display Powered by XIAO nRF52840 Plus

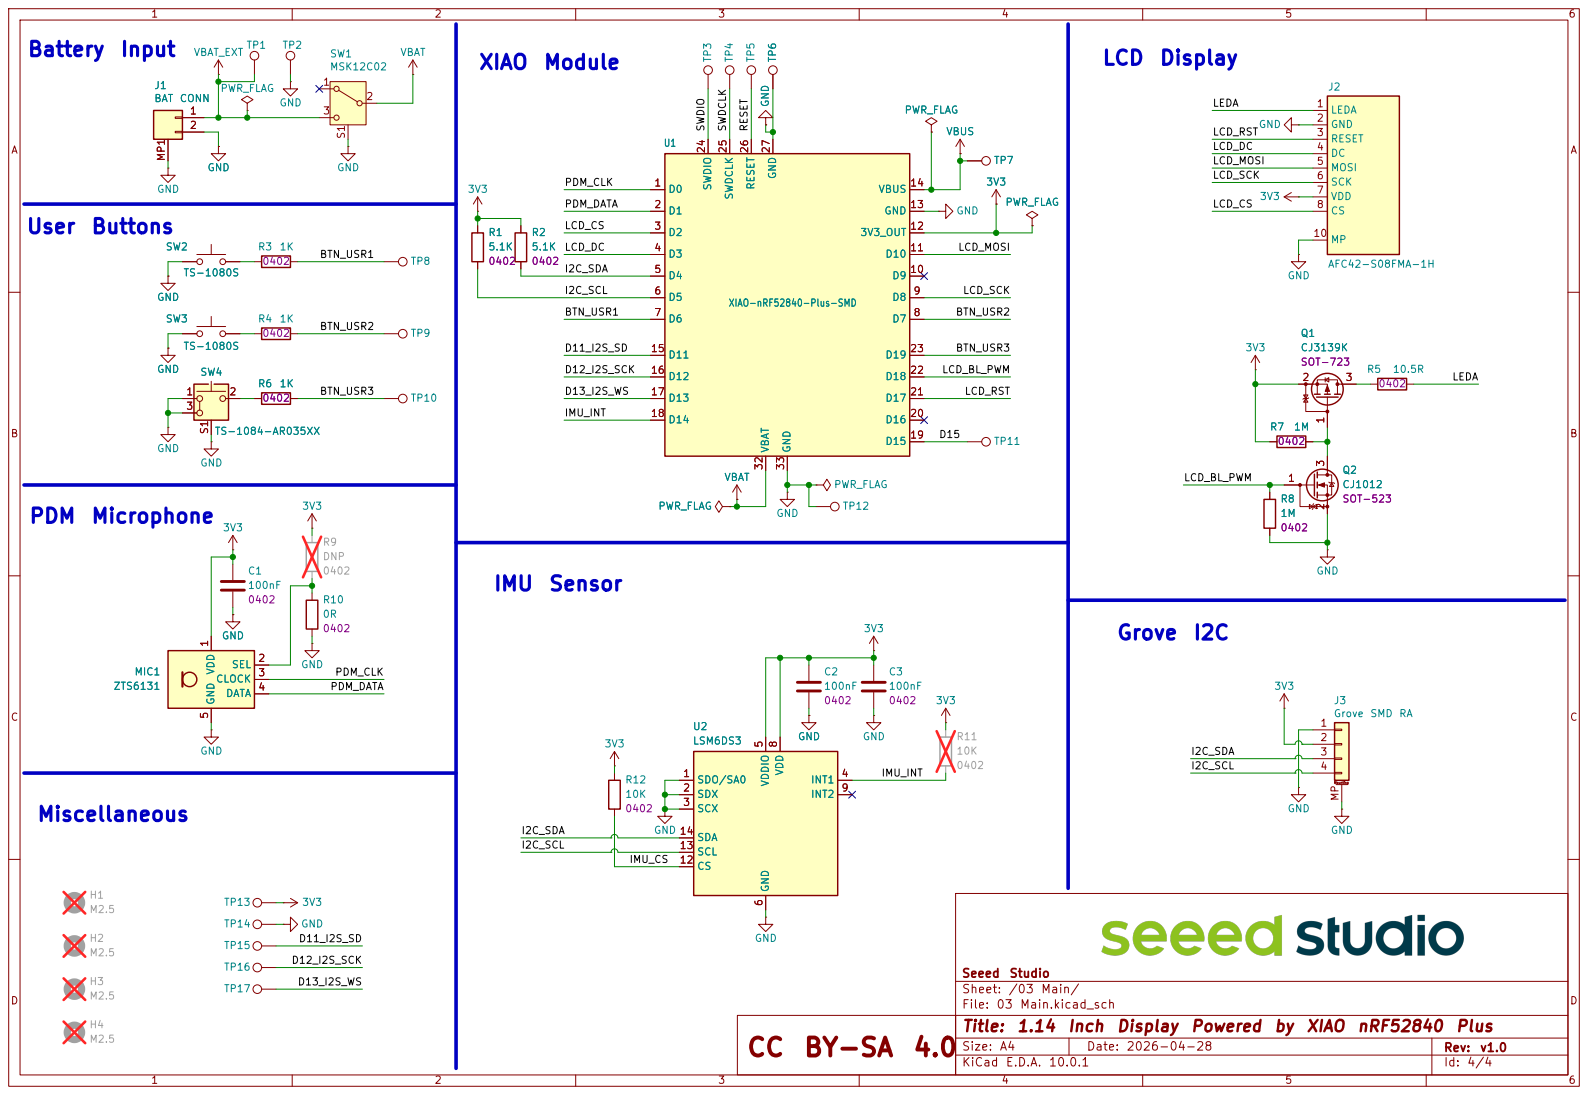
[picture p127: page 4]

Seeed Studio
Sheet: /03 Main/
File: 03 Main.kicad_sch
Title: 1.14 Inch Display Powered by XIAO nRF52840 Plus
