FaiyuetCik/Display-Gadgets/code/example/147_nRF52840/1.47 Inch Touch Display Powered by XIAO nRF52840 Plus_v1.0.pdf

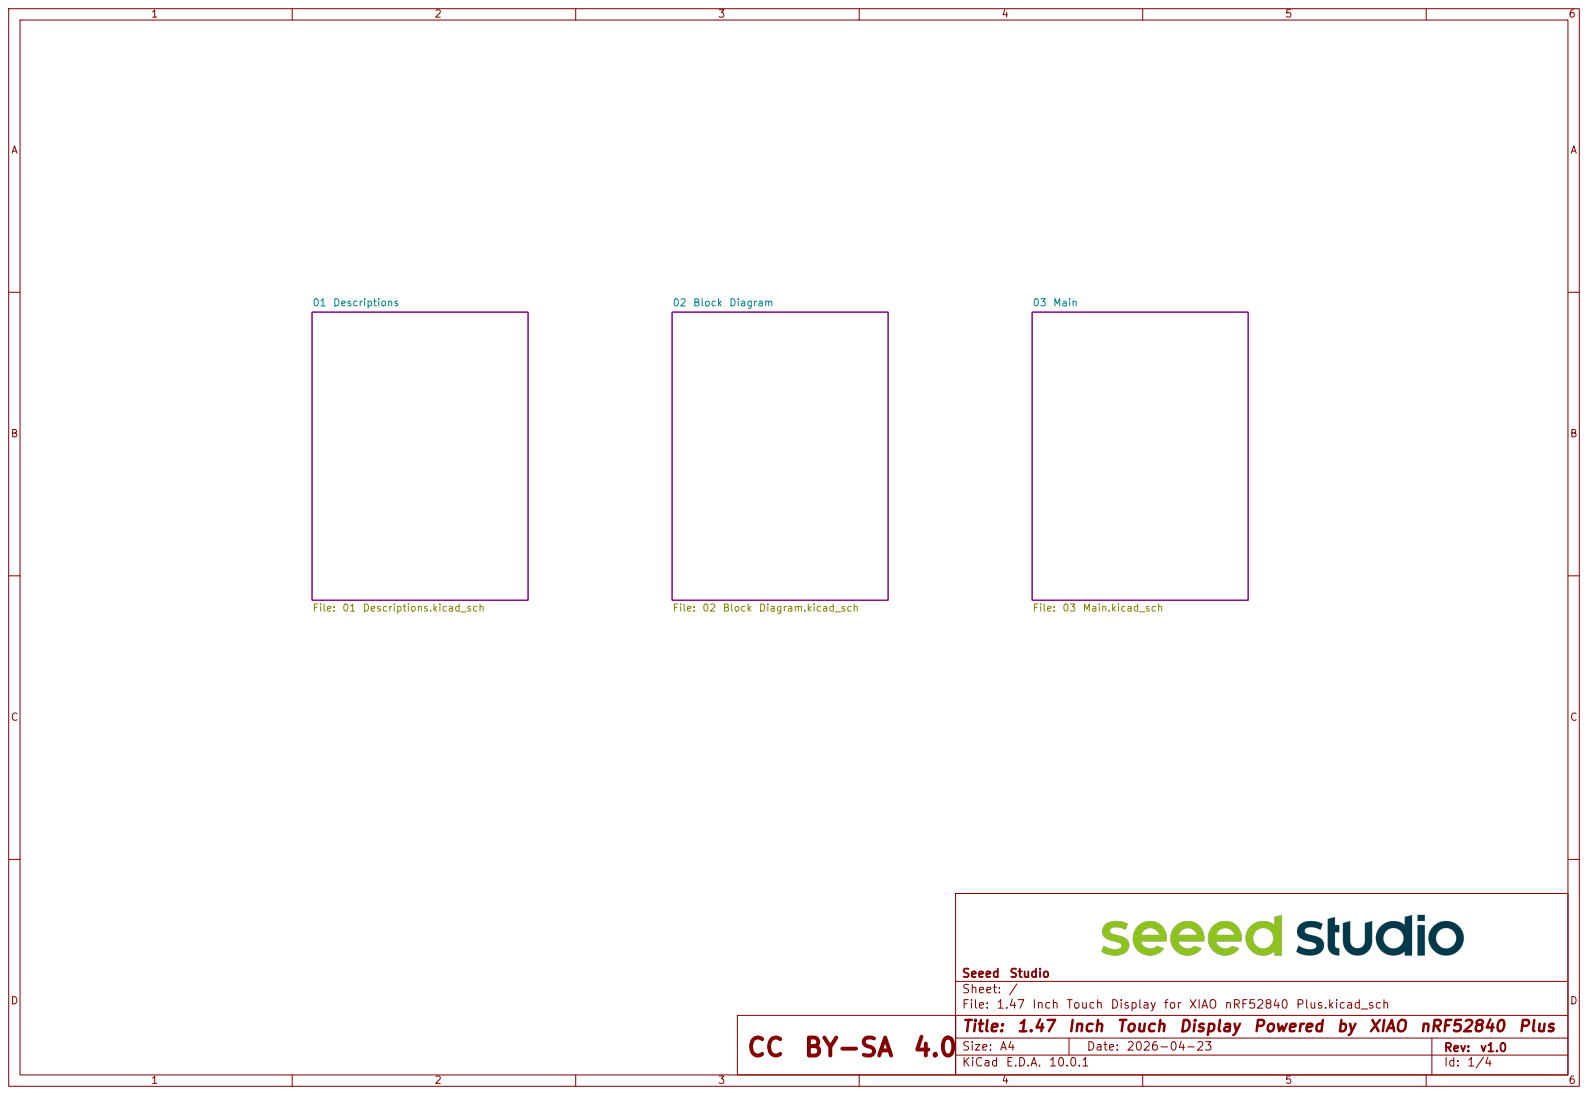
[picture p132: page 1]

File: 03 Main.kicad_sch 02 Block Diagram

Seeed Studio
Sheet: /
File: 1.47 Inch Touch Display for XIAO nRF52840 Plus.kicad_sch

CC BY-SA 4.0 | Title: 1.47 Inch Touch Display Powered by XIAO nRF52840 Plus

Size: A4 | | Rev: v1.0
KiCad E.D.A. 10.0.1 | | Id: 1/4

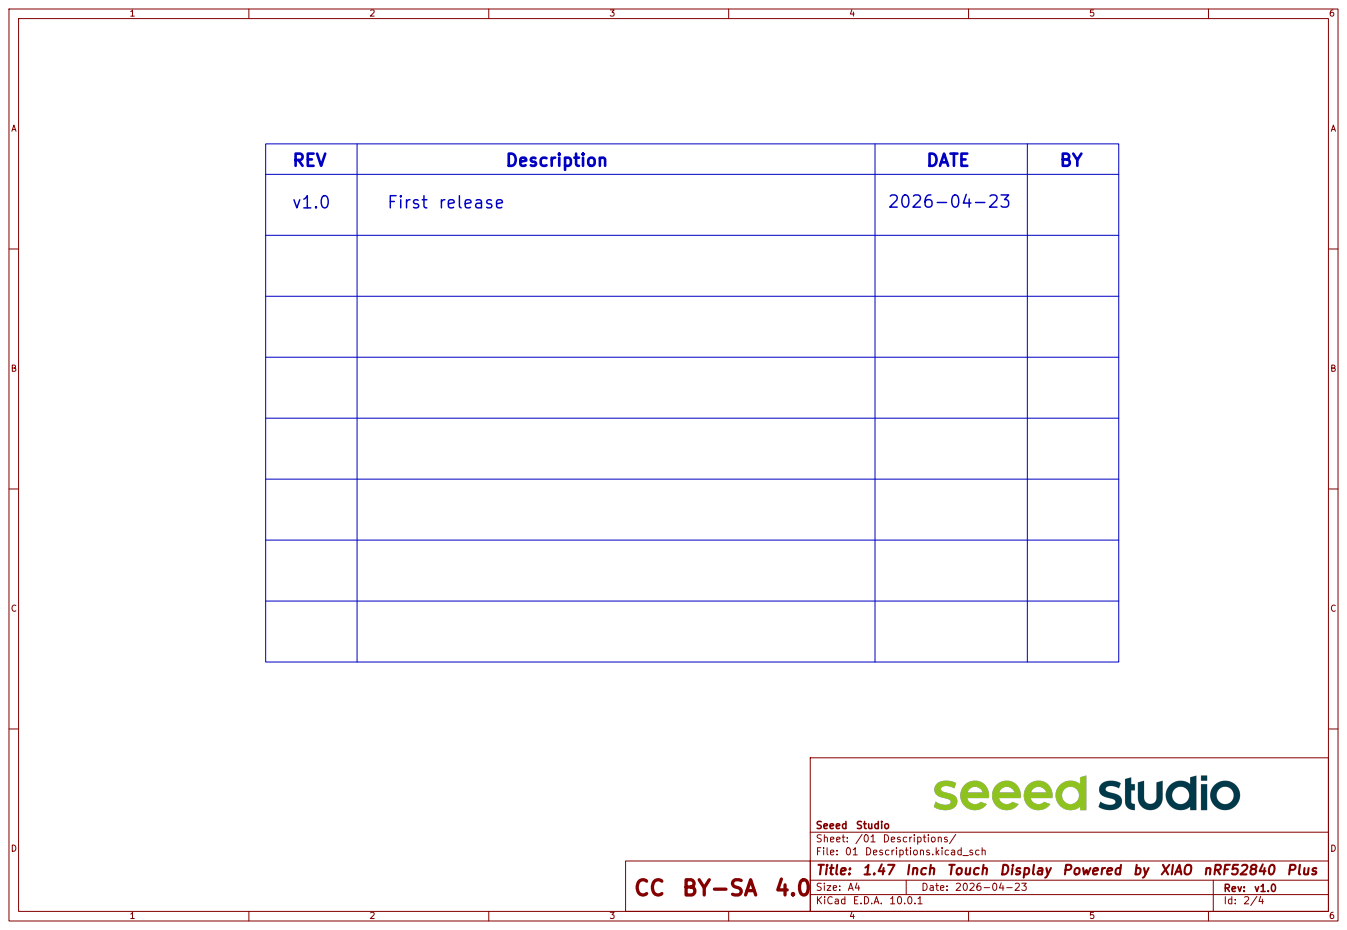
[picture p133: page 2]

REV | Description | DATE | BY

v1.0 | First release | 2026-04-23

Seeed Studio
Sheet: /01 Descriptions/
File: 01 Descriptions.kicad_sch
Title: 1.47 Inch Touch Display Powered by XIAO nRF52840 Plus

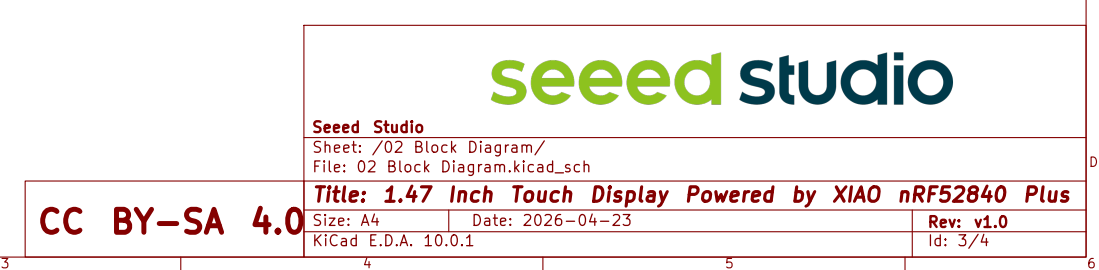
[picture p134: page 3]

Seeed Studio
Sheet: /02 Block Diagram/
File: 02 Block Diagram.kicad_sch
Title: 1.47 Inch Touch Display Powered by XIAO nRF52840 Plus

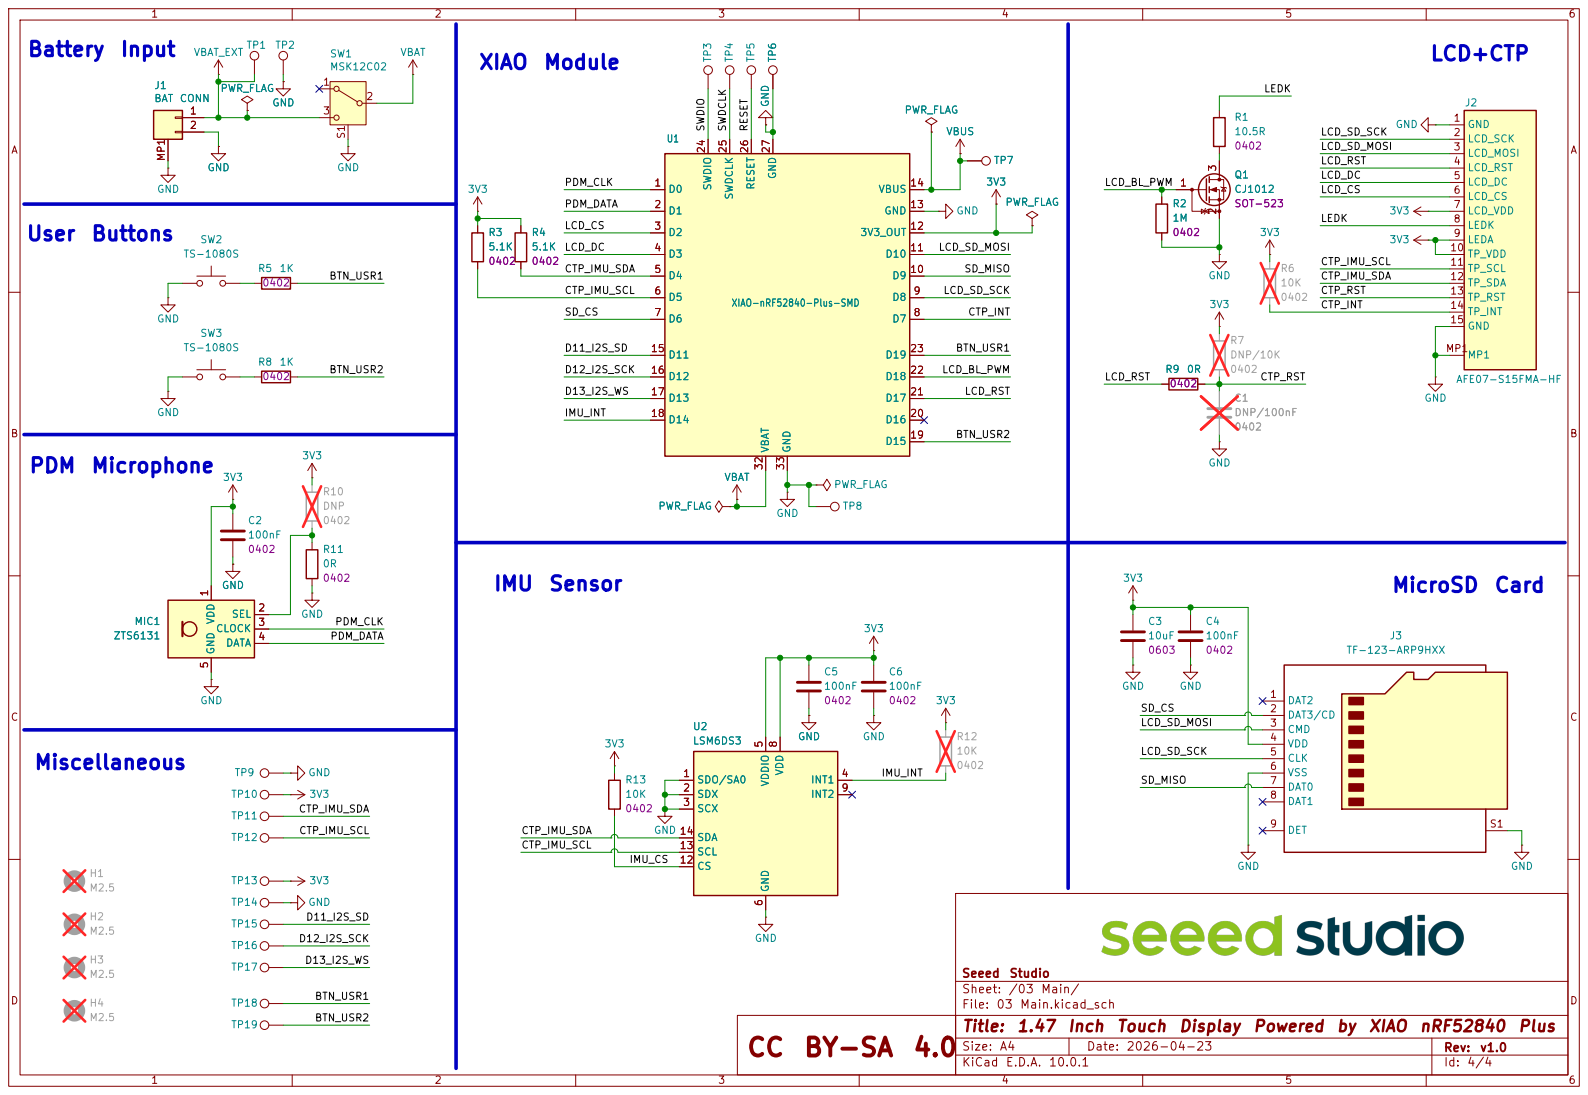
[picture p135: page 4]

Seeed Studio
Sheet: /03 Main/
File: 03 Main.kicad_sch
Title: 1.47 Inch Touch Display Powered by XIAO nRF52840 Plus
