FaiyuetCik/Display-Gadgets/resources/schematic/XIAO 0.96'' IPS Display (ESP32-S3) Schematic.pdf

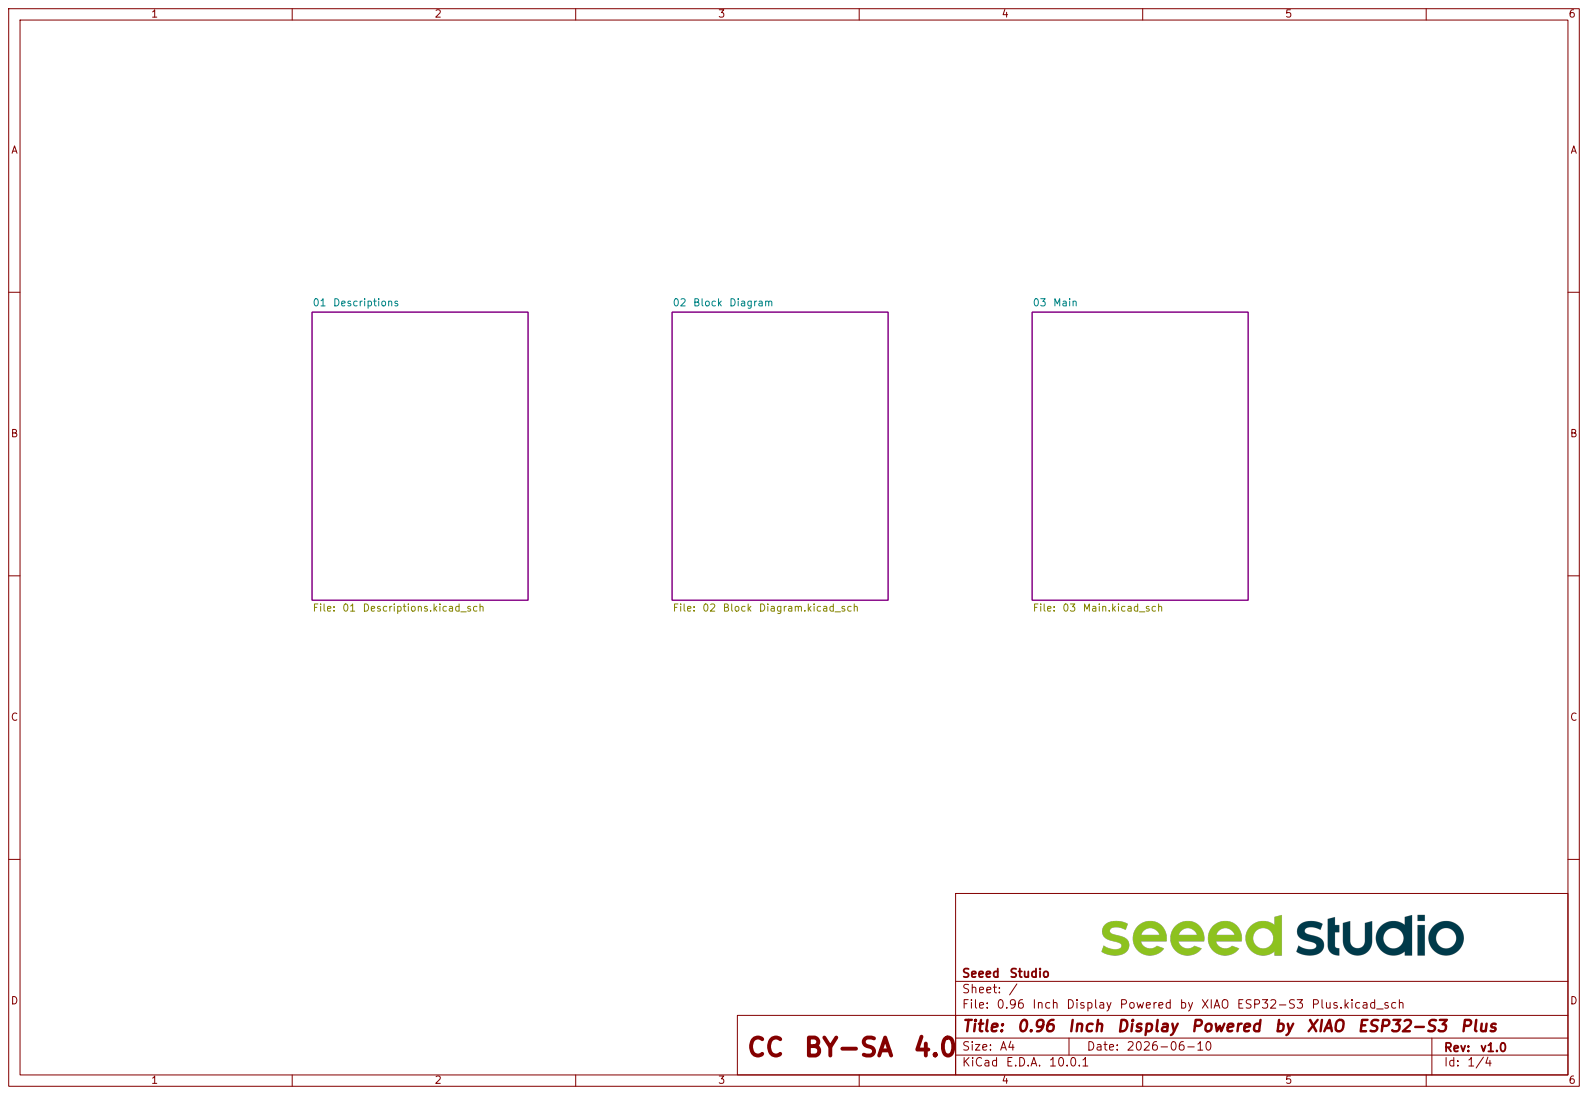
[picture p136: page 1]

File: 03 Main.kicad_sch 01 Descriptions File: 01 Descriptions.kicad_sch

Seeed Studio
Sheet: /
File: 0.96 Inch Display Powered by XIAO ESP32-S3 Plus.kicad_sch

CC BY-SA 4.0 | Title: 0.96 Inch Display Powered by XIAO ESP32-S3 Plus

Size: A4 | | Rev: v1.0
KiCad E.D.A. 10.0.1 | | Id: 1/4

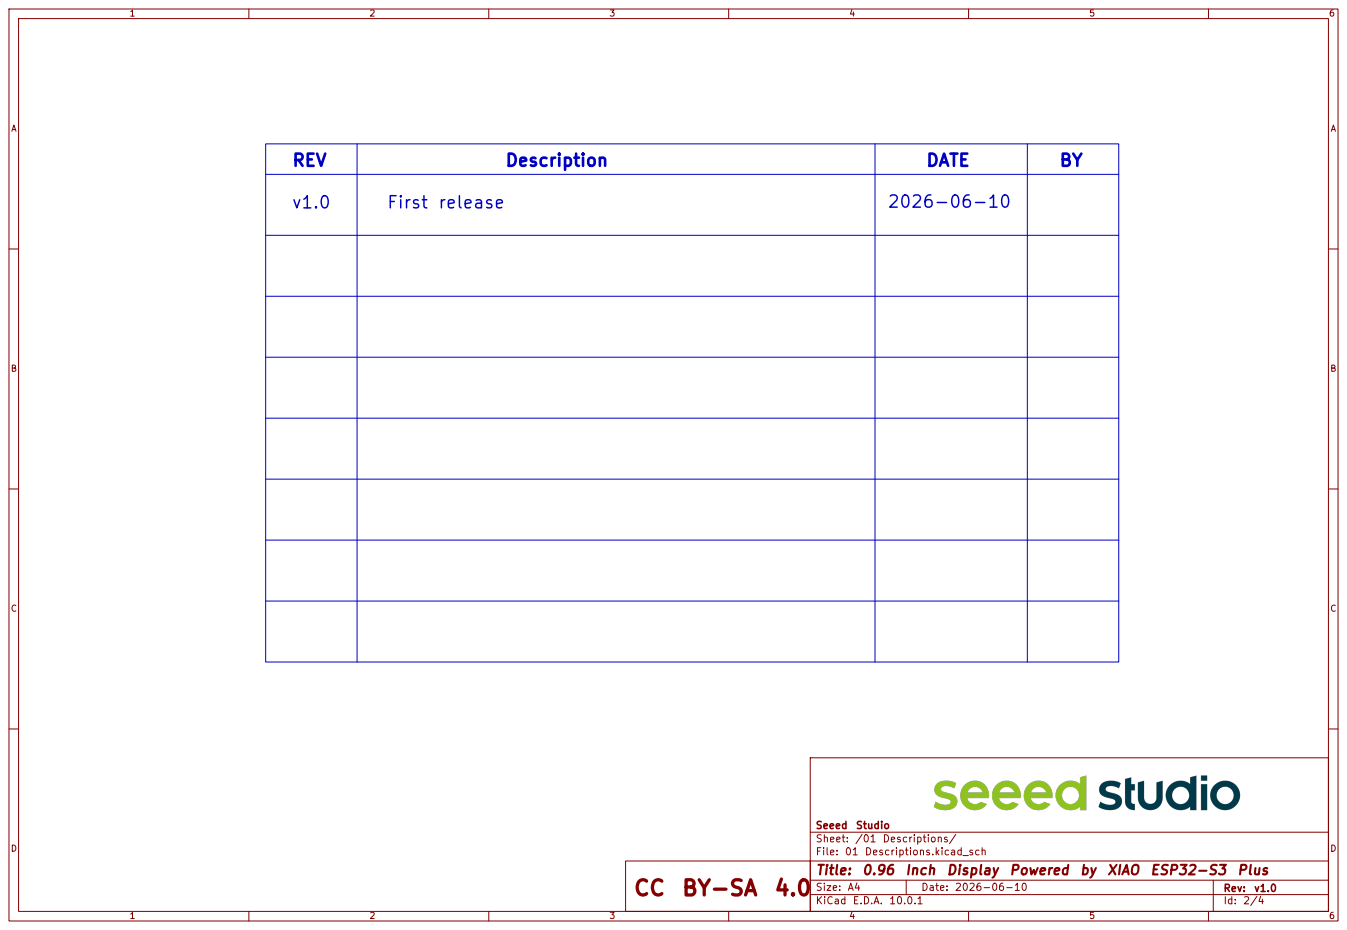
[picture p137: page 2]

REV | Description | DATE | BY

v1.0 | First release | 2026-06-10

Seeed Studio
Sheet: /01 Descriptions/
File: 01 Descriptions.kicad_sch
Title: 0.96 Inch Display Powered by XIAO ESP32-S3 Plus

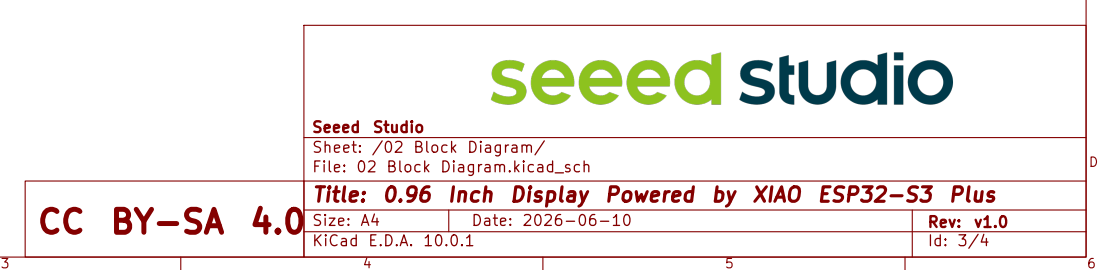
[picture p138: page 3]

Seeed Studio
Sheet: /02 Block Diagram/
File: 02 Block Diagram.kicad_sch
Title: 0.96 Inch Display Powered by XIAO ESP32-S3 Plus

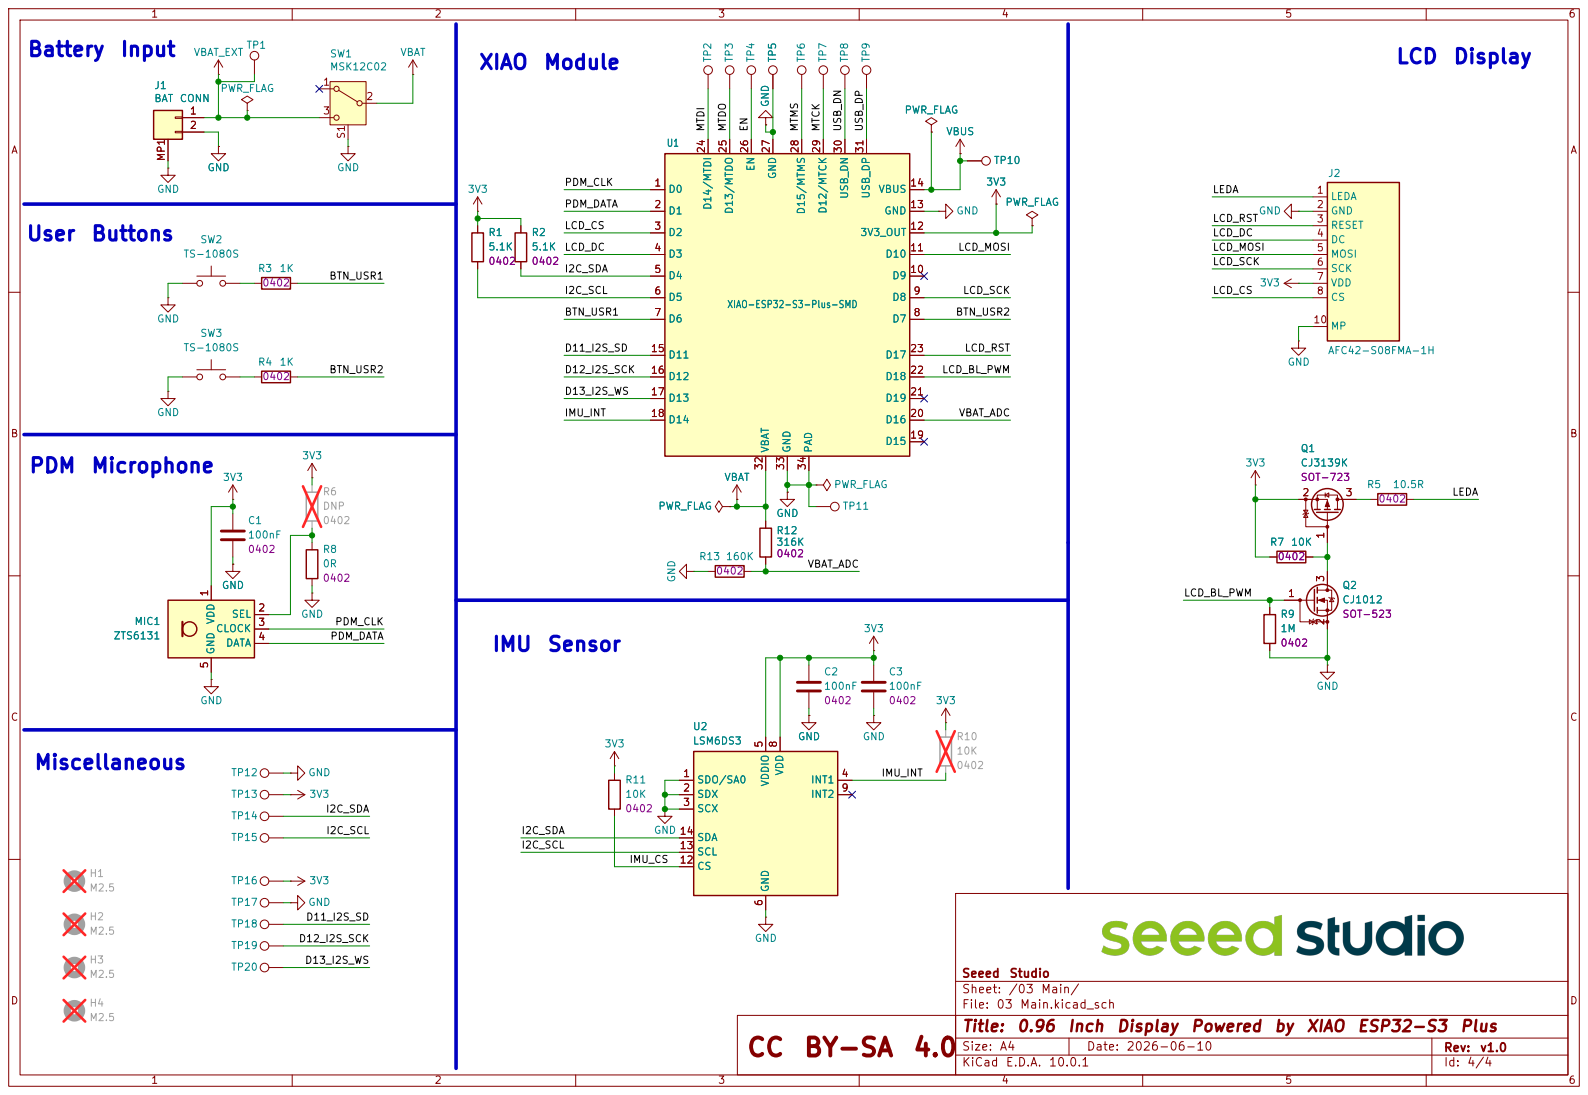
[picture p139: page 4]

Seeed Studio
Sheet: /03 Main/
File: 03 Main.kicad_sch
Title: 0.96 Inch Display Powered by XIAO ESP32-S3 Plus
