FaiyuetCik/Display-Gadgets/resources/schematic/XIAO 1.14'' IPS Display (ESP32-S3) Schematic.pdf

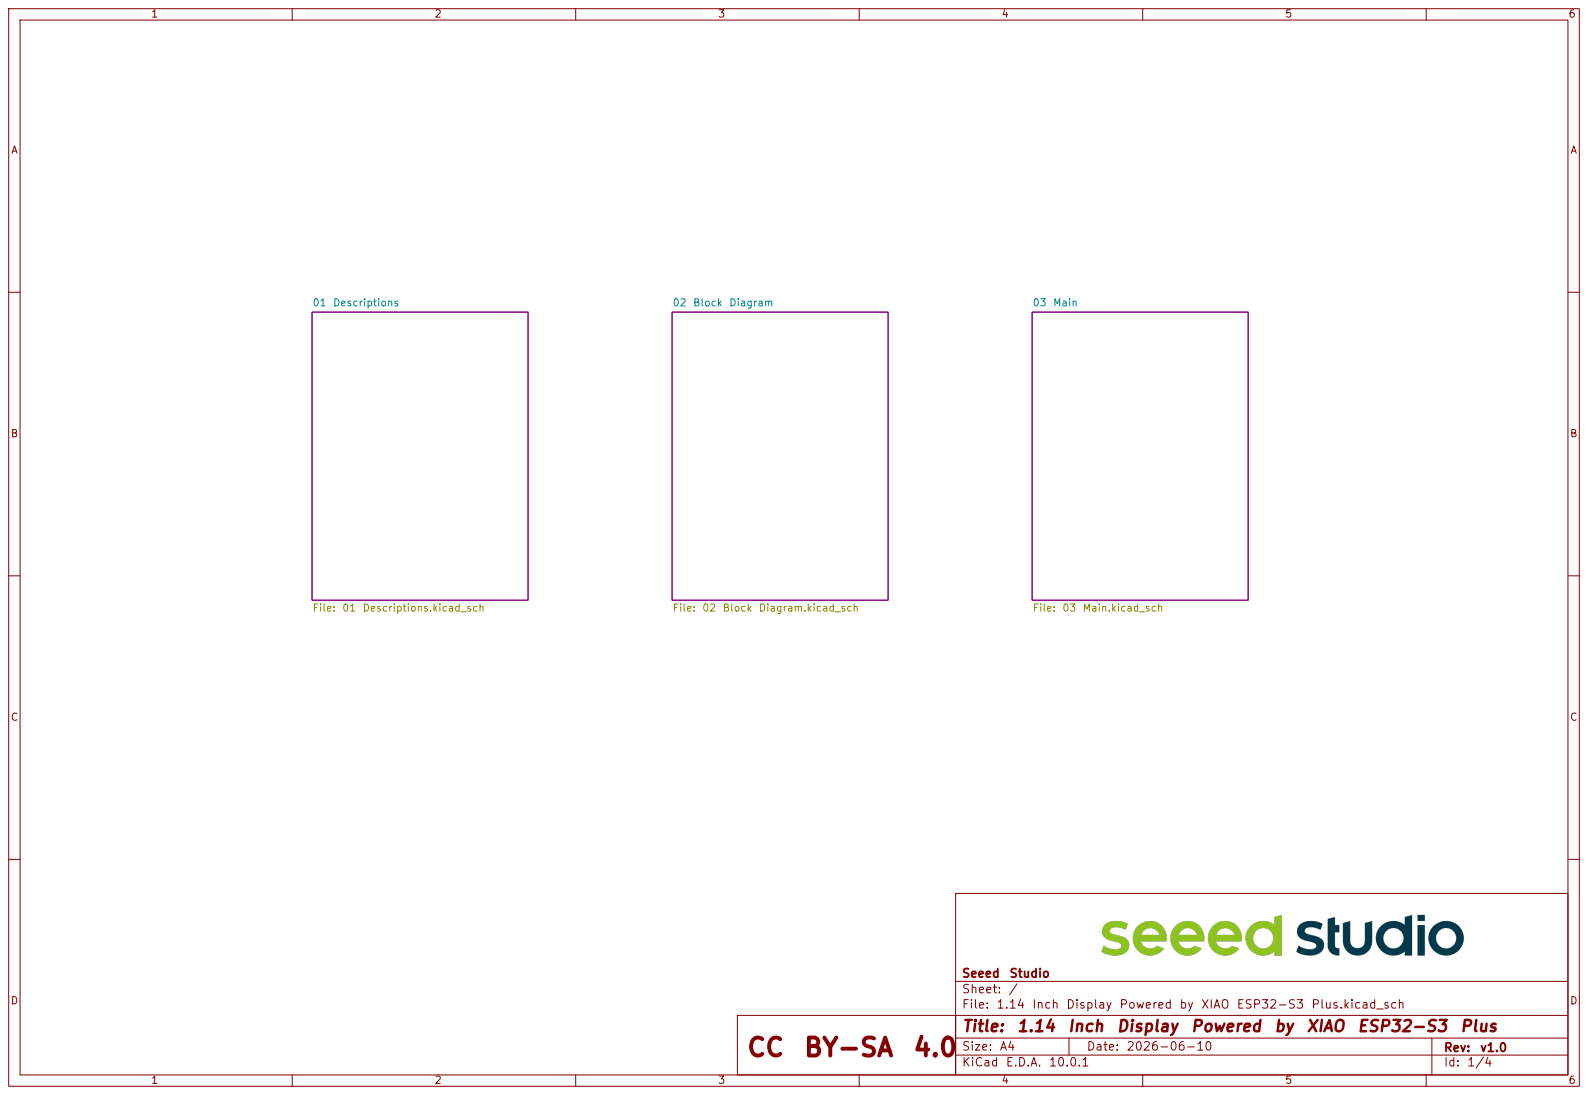
[picture p144: page 1]

Seeed Studio
Sheet: /
File: 1.14 Inch Display Powered by XIAO ESP32-S3 Plus.kicad_sch

CC BY-SA 4.0 | Title: 1.14 Inch Display Powered by XIAO ESP32-S3 Plus

Size: A4 | | Rev: v1.0
KiCad E.D.A. 10.0.1 | | Id: 1/4

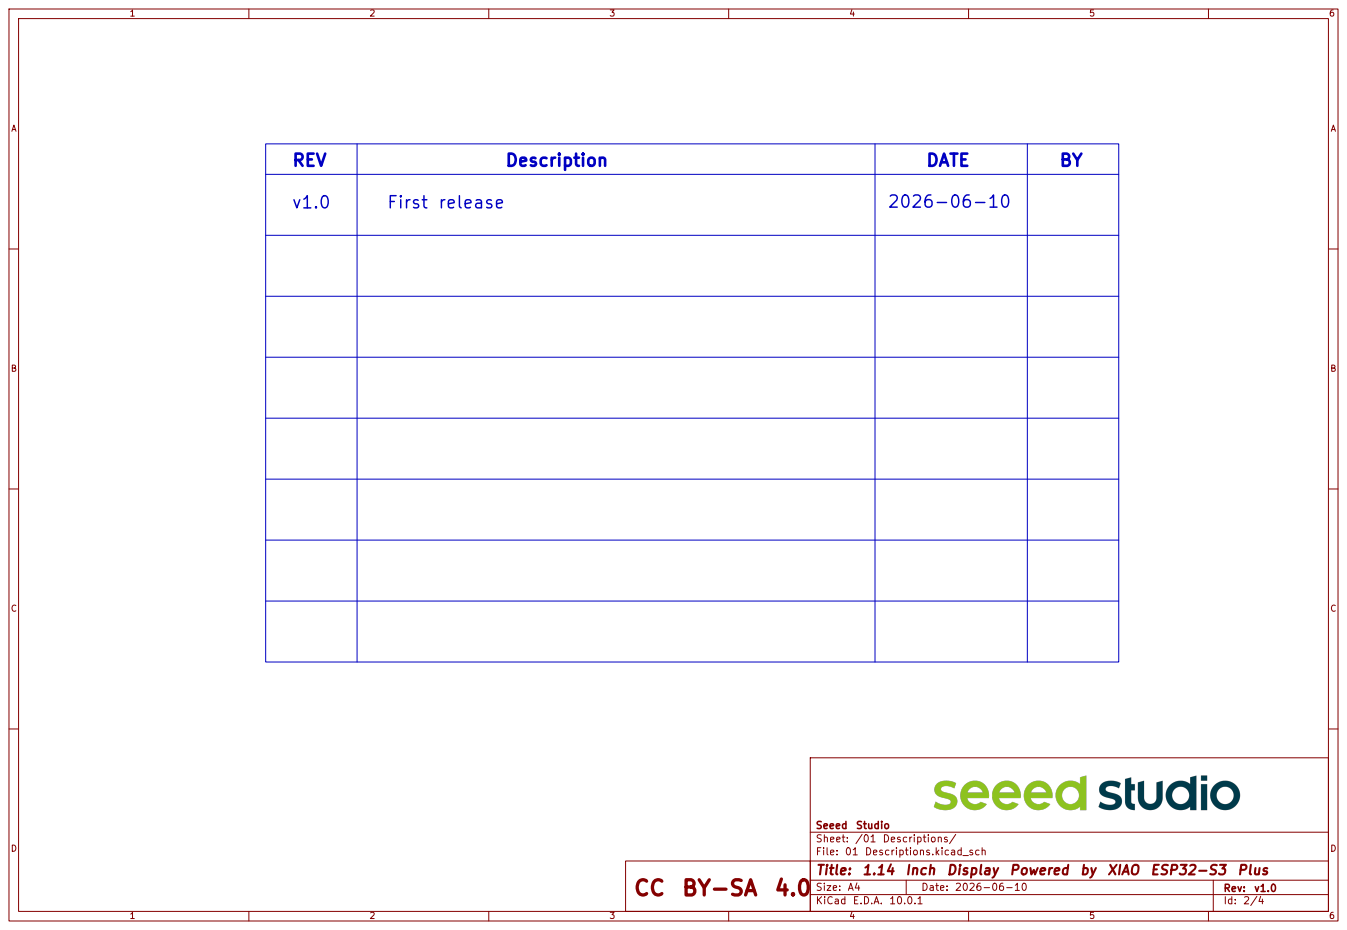
[picture p145: page 2]

REV | Description | DATE | BY

v1.0 | First release | 2026-06-10

Seeed Studio
Sheet: /01 Descriptions/
File: 01 Descriptions.kicad_sch
Title: 1.14 Inch Display Powered by XIAO ESP32-S3 Plus

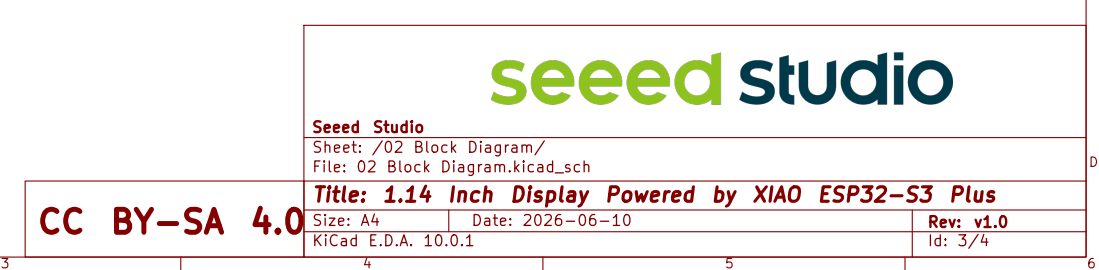
[picture p146: page 3]

Seeed Studio
Sheet: /02 Block Diagram/
File: 02 Block Diagram.kicad_sch
Title: 1.14 Inch Display Powered by XIAO ESP32-S3 Plus

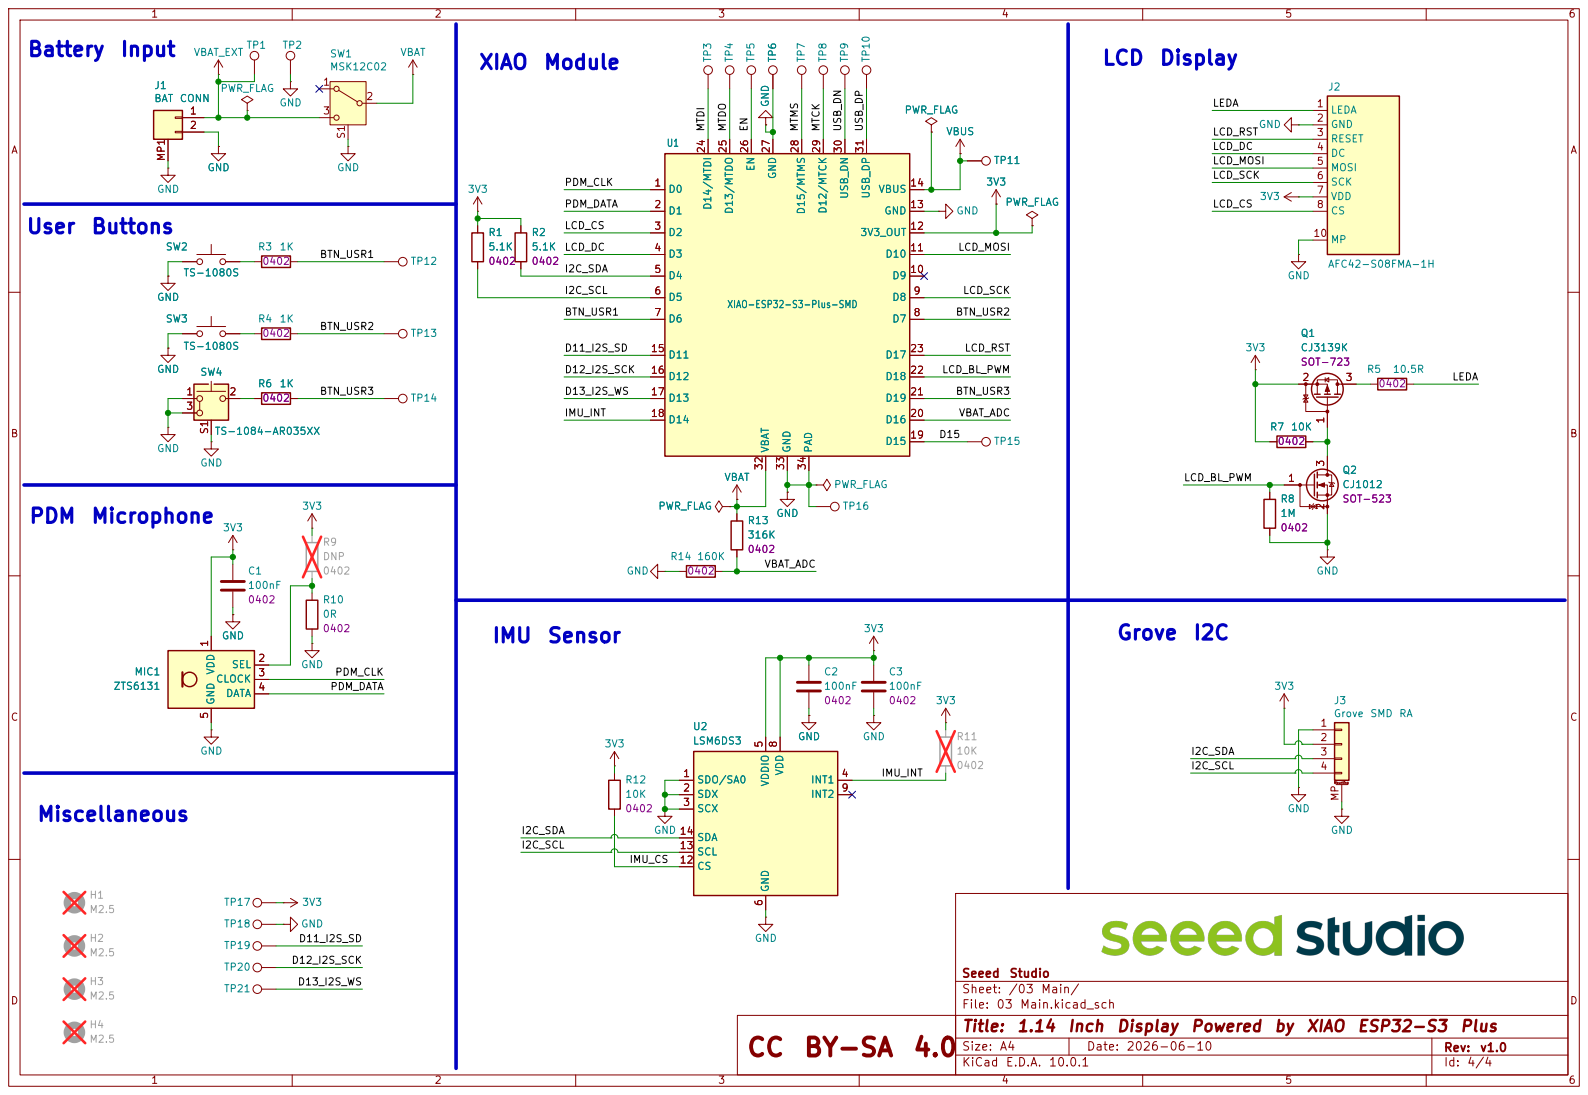
[picture p147: page 4]

Seeed Studio
Sheet: /03 Main/
File: 03 Main.kicad_sch
Title: 1.14 Inch Display Powered by XIAO ESP32-S3 Plus
