FaiyuetCik/Display-Gadgets/(commit log)

2026-06-04 Add initial packages and drivers
2026-06-05 Split basic examples by pin function
2026-06-05 Fix serial bug: add #include <Adafruit_TinyUSB.h>
    [axs5106l_device.cpp]
2026-06-05 Replace drivers with Seeed library equivalents
    [driver.h]
2026-06-05 Fix I2S pin assignments
2026-06-11 Add ESP32-S3 battery reading example
2026-06-23 Add SD card image reader basic example, fix display color inversion
    [driver.h, ui.ino]
2026-07-30 Add: XIAO Display Board 6-screen code and schematics
2026-07-31 Rename schematics directory for all 6 products
2026-08-06 Add bilingual README: English + 简体中文 with language switcher
2026-08-06 Fix wiki navigation path: Sensor → Sensing
2026-08-07 Add 0703 Dashboard for 1.47 ESP32-S3 and esp_lcd_touch_axs5106l library
2026-08-07 Restructure esp_lcd_touch_axs5106l to Arduino standard format (src/ + library.properties)
2026-08-12 @ feat: add 0715 Dashboards, ESP32-S3 function demos, and dashboard images
    New Dashboards (0715):
    - 1.47 nRF52840: v2.8 Battery UI Color Cache Fix
    - 1.14 nRF52840: v1.0.8 timeout-safe I2C hot-plug + battery stable UI
    - 0.96 nRF52840: 0715 Dashboard
    - 0.96 ESP32: 0708 Dashboard
    - 1.14 ESP32: 0715 Dashboard
    New Function demos (147 ESP32-S3):
    - mic_canvas: PDM microphone volume bar
    - touch_circle: AXS5106L interactive touch drawing
    - electronic_quicksand ZIP archive
    New Function demos (096 ESP32-S3):
    - graphictest, electronic_quicksand, wakeup
    Dashboard images:
    - 1.14 nRF52840: 11 images (GIF/JPG/PNG)
    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
    [0708_DashBoard_096_ESP32.ino, 0715_DashBoard_096_nRF52840.ino, 0715_DashBoard_114_nRF52840.ino, 0715_DashBoard_147_nRF52840.ino, axs5106l_device.cpp, axs5106l_device.h, driver.h, xiao_esp32s3_096_electronic_quicksand.ino]
2026-08-12 fix: voice_bar waveform color thresholds to match actual PDM mic range
    [xiao_nrf52840_114_voice_bar.ino]
2026-08-12 fix: align waveform color thresholds with volume bar (50%/90%)
    [xiao_nrf52840_114_voice_bar.ino]
2026-08-12 fix: waveform color driven by smoothed volume instead of raw samples
    [xiao_nrf52840_114_voice_bar.ino]
2026-08-17 feat: add 1.14 ESP32-S3 counter and voice_bar demos, 0715 Dashboard, and images
2026-08-20 Add: 1.47 ESP32-S3 Plus SD BMP Reader Diagnostic v0.8
2026-08-20 Add: 1.47 ESP32-S3 Plus function GIFs + SD test.bmp
2026-08-20 Add: 0.96 ESP32-S3 Plus 0715 Dashboard (v1.13.3, KEY1 brightness + KEY2 backlight)
2026-08-20 Add: 1.47 ESP32-S3 Plus I2S speaker test v1.1 (correct pins)
    [xiao_esp32s3plus_i2s_speaker_test_v1_1_correct_pins.ino]
2026-08-21 fix(147 nRF Dashboard): add missing axs5106l_device touch driver files and repack zip
    [axs5106l_device.cpp, axs5106l_device.h]
2026-08-24 fix(096 ESP32-S3): switch 3 Function demos from Seeed_GFX to Arduino_GFX for 80x160 panel
    [xiao_esp32s3_096_electronic_quicksand.ino, xiao_esp32s3_096_graphictest.ino, xiao_esp32s3_096_wakeup.ino]
2026-08-25 Add: 1.47 ESP32-S3 Plus SD record with I2S playback
2026-08-25 fix(1.14 ESP32-S3): add mic warm-up and capture timeout to flash record
    [xiao_esp32s3_114_flash_record.ino]
2026-08-26 feat(0.96 ESP32-S3): add flash recorder demo
    USR1 records 5s of PDM audio at 16 kHz mono to onboard LittleFS
    (/REC_RAW.WAV); USR2 plays it back through a MAX98357A on D11/D12/D13.
    - ESP-IDF v5 I2S PDM RX (capture) + I2S STD stereo (playback)
    - 300 ms PDM warm-up discard and a 7 s capture timeout
    - Onboard mic drives the left PDM slot (R8 straps SEL to GND)
2026-08-28 docs: update README to reflect all 6-board Function demos and current libraries
2026-09-04 feat(code_GFX2): add Seeed_GFX2-migrated Function demos (34 demos across 6 display boards)
2026-09-05 fix(147_nrf52840): use Seeed LSM6DS3.h in wakeup demo to match docs
    [xiao_nrf52840_147_wakeup.ino]
2026-09-05 fix(code_GFX2): rename Config_XIAO_ to Config_Seeed_ for 1.47 JD9853A (14 demos)
    [xiao_esp32s3_147_electronic_quicksand.ino, xiao_esp32s3_147_graphictest.ino, xiao_esp32s3_147_mic_canvas.ino, xiao_esp32s3_147_sd_record.ino, xiao_esp32s3_147_touch_circle.ino, xiao_esp32s3_147_wakeup.ino, xiao_esp32s3plus_147_sd_bmp_reader_diag_v0_8.ino, xiao_nrf52840_147_electronic_quicksand.ino]
2026-09-05 docs(README): reflect Seeed_GFX2 migration, code_GFX2 structure, and IMU library split
2026-09-07 feat(Display Gadgets): add product resources (KiCad, schematic, 3D model, datasheet, enclosure)
2026-09-07 feat(Display Gadgets): add factory firmware binaries (ESP32-S3 bins + nRF52840 uf2)
